DamianSeredyn/IHP__PLL0663/release/v.1.0.0/doc/Datasheet.md

# PLL0663 – Datasheet

Phase-locked loop in IHP SG13CMOS5L · Release v1.0.0

## 1. Overview

PLL0663 is a phase-locked loop for the IHP SG13CMOS5L process. It consists of a
phase-frequency detector (PFD), a charge pump (CP), several voltage-controlled oscillators (VCO)
selected by a VCO decoder, a programmable divider, an input register and a bandgap block with two on-chip voltage references. The loop
filter is **external** (off-chip).

### Key features

- Output frequency range: 32 kHz – 150 MHz
- Reference frequency: 32 kHz
- Divider ratio N: 2 – 9984; `f_out = N × f_ref / 2` (the output is divided by 2)
- Core supply `vp` 1.2 V; all circuits inside the PLL run from 1.2 V
- 3.3 V supply `vph` for the input buffers only; bandgap supply `vp_bandgap` 3.3 V or 1.8 V, depending on the reference under test (section 6.5)
- Serial input register (`clk_in`, `data_in`, `data_en`) for the divider code and the debug multiplexer code
- Debug output (`debug_out`) with a multiplexer for internal test signals
- Two on-chip bandgap voltage references (`bandgap_res`, `bandgap_selfbias`), outputs `vref_res` and `vref_sb`
- Power consumption up to 100 mW (at the highest output frequency)
- Lock time: 1 ms (see section 7 for conditions)
- Silicon area: 1050 µm × 1050 µm including sealring (1.1025 mm²)

## 2. Block diagram

<p align="center">
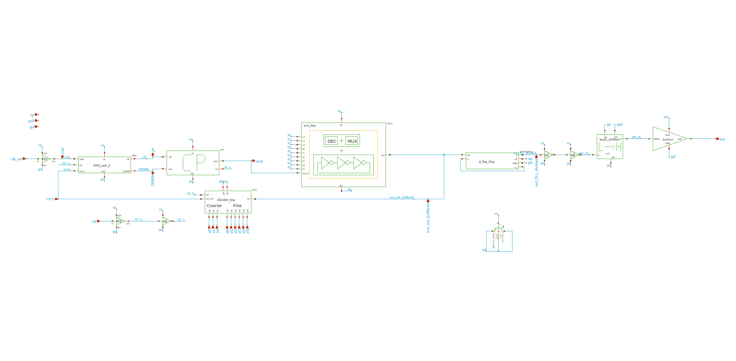
[picture p1: release/v.1.0.0/doc/img/PLL_top.png]
PLL top-level schematic (PLL_top)
  <br>
  <em>Figure 1: PLL top-level schematic (<code>PLL_top</code>)</em>
</p>

<p align="center">
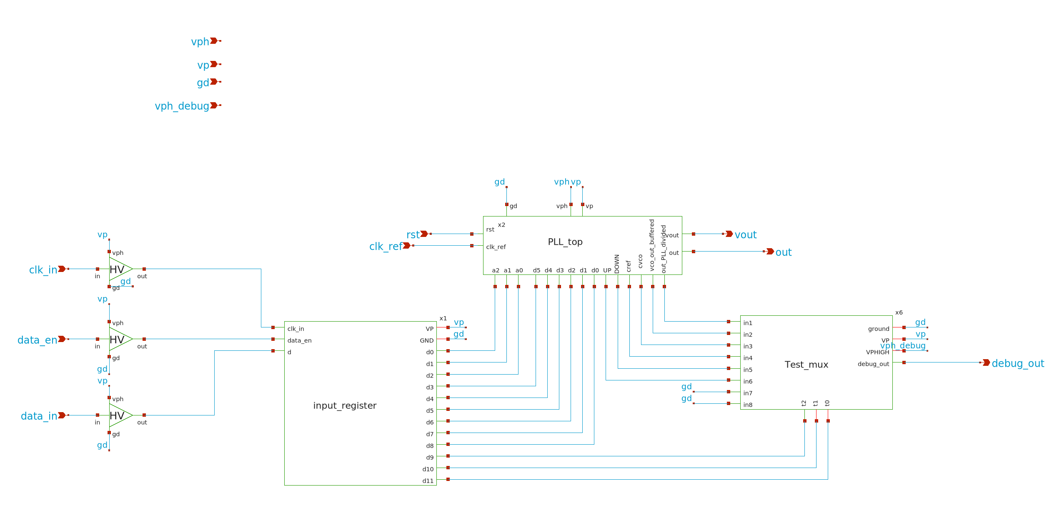
[picture p2: release/v.1.0.0/doc/img/Chip_top.png]
chip top-level schematic (Chip_top)
  <br>
  <em>Figure 2: chip top-level schematic (<code>Chip_top</code>)</em>
</p>

## 3. Pin description

Pin names are those of the extracted top-level subcircuit. All signal pins and the supply `vph`
are in the 3.3 V domain; the bandgap supply `vp_bandgap` is 3.3 V or 1.8 V (section 6.5); `vp` is the 1.2 V core supply. Only the input buffers are
supplied from `vph`; all circuits inside the PLL are supplied from `vp` (1.2 V).

| Pin | Direction | Domain | Description |
|---|---|---|---|
| `gd` | supply | 0 V | Ground |
| `vp` | supply | 1.2 V | Core supply (all circuits inside the PLL) |
| `vph` | supply | 3.3 V | 3.3 V supply of the input buffers only |
| `vp_bandgap` | supply | 3.3 V / 1.8 V | Bandgap supply: 3.3 V for `bandgap_res`, 1.8 V for `bandgap_selfbias` (section 6.5) |
| `clk_ref` | in | 3.3 V | Reference clock (32 kHz) |
| `rst` | in | 3.3 V | Reset, active high; resets all elements of the PLL |
| `clk_in` | in | 3.3 V | Input register: external clock of the serial interface |
| `data_in` | in | 3.3 V | Input register: serial data (divider code and debug multiplexer code) |
| `data_en` | in | 3.3 V | Input register: enable; while asserted, `data_in` is shifted into the register on successive `clk_in` clock cycles |
| `out` | out | 3.3 V | PLL output clock |
| `vout` | analog | 3.3 V | Charge-pump / VCO control node, connection of the external loop filter |
| `debug_out` | out | 3.3 V | Output of the debug multiplexer (internal test signals, selected via the input register) |
| `vref_sb` | analog | – | Reference voltage output of `bandgap_selfbias` (no internal buffer) |
| `vref_res` | analog | – | Reference voltage output of `bandgap_res` (no internal buffer) |

### 3.1 Input register

The input register is a serial-in, parallel-out (SIPO) shift register, loaded through `clk_in`,
`data_in` and `data_en`. `clk_in` is an external clock (independent of `clk_ref`). As long as
`data_en` is asserted, `data_in` is shifted into the register on successive `clk_in` clock cycles.

The serial word is 12 bits long:

| Bits | Field |
|---|---|
| D0 – D8 | divider code (9 bits) |
| D9 – D11 | code of the debug output multiplexer (3 bits, selects the signal routed to `debug_out`) |

The register content is valid only after the transmission of the last bit (D11) is complete.

<p align="center">
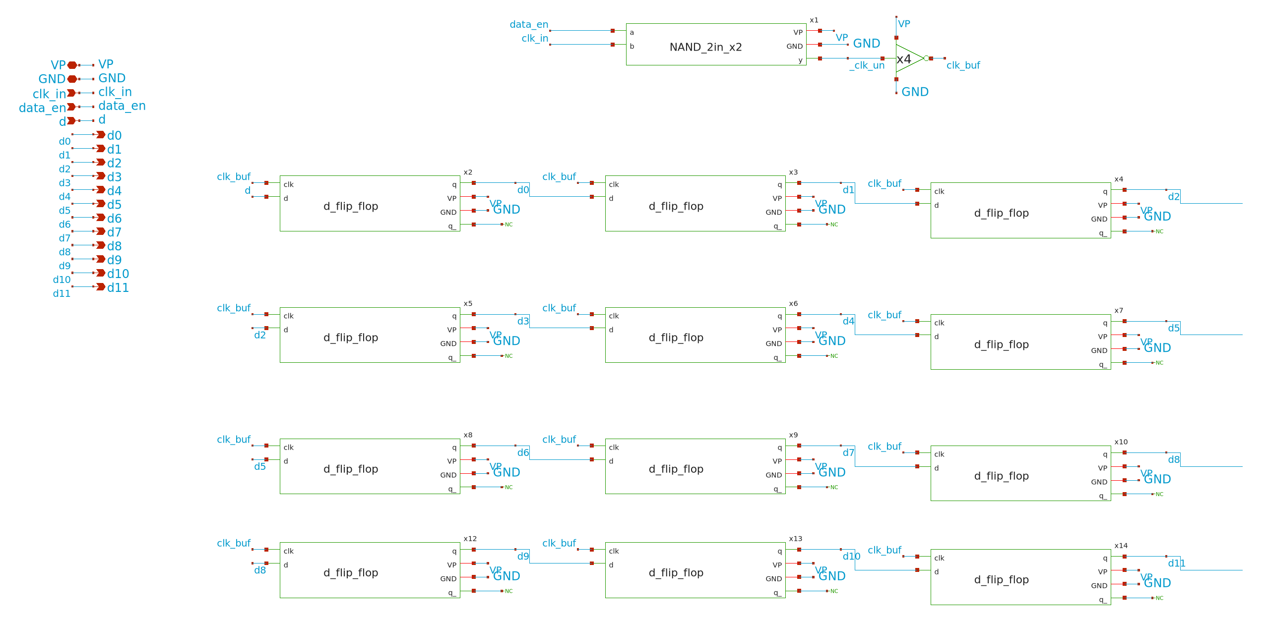
[picture p3: release/v.1.0.0/doc/img/input_register.png]
input register (input_register)
  <br>
  <em>Figure 3: input register (<code>input_register</code>)</em>
</p>

TODO: bit order on the line (assumed D0 first, D11 last), timing diagram (setup/hold of `data_in`
and `data_en` with respect to `clk_in`, maximum `clk_in` frequency), active level of `data_en`,
debug multiplexer codes and the signal selected by each code.

### 3.2 Output buffer and level shifters

<table>
<tr>
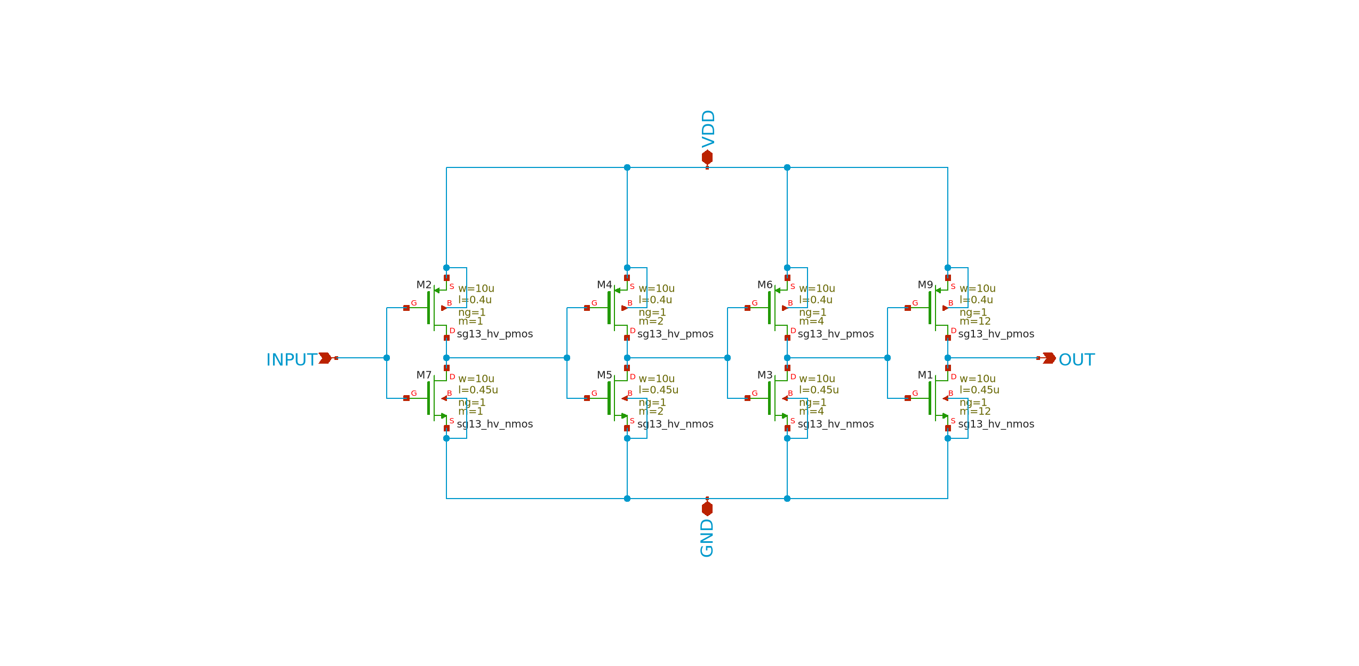
[picture p4: release/v.1.0.0/doc/img/buf.png]
output buffer (buf)
<td align="center" width="50%"><br><em>Figure 4: output buffer (<code>buf</code>)</em></td>
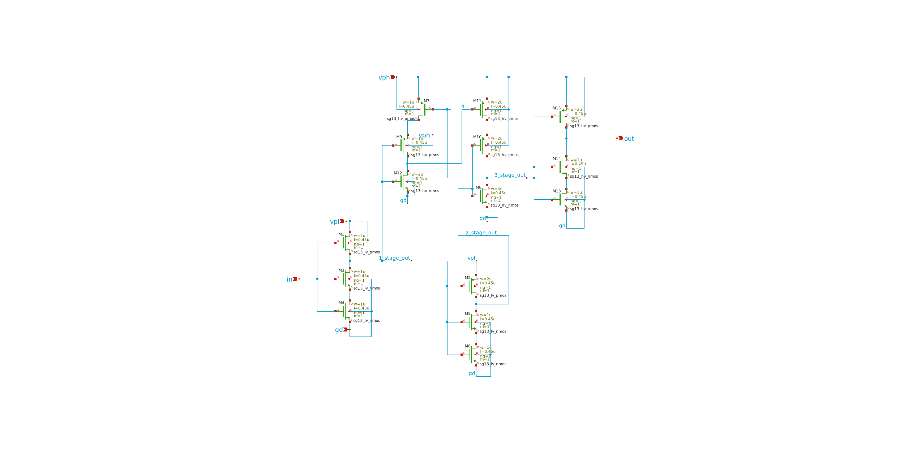
[picture p5: release/v.1.0.0/doc/img/level_shifter.png]
level shifter (level_shifter)
<td align="center" width="50%"><br><em>Figure 5: level shifter (<code>level_shifter</code>)</em></td>
</tr>
</table>

TODO: short description (which pins use them, 3.3 V to 1.2 V translation).

## 4. Operating conditions

| Parameter | Min | Typ | Max | Unit |
|---|---|---|---|---|
| Core supply `vp` | 1.08 | 1.2 | 1.32 | V |
| 3.3 V supply `vph` | 3.1 | 3.3 | 3.5 | V |
| Bandgap supply `vp_bandgap` (`bandgap_res`) | 2.97 | 3.3 | 3.63 | V |
| Bandgap supply `vp_bandgap` (`bandgap_selfbias`) | 1.62 | 1.8 | 1.98 | V |
| Temperature | -25 | 27 | 125 | °C |
| Reference frequency | – | 32 | – | kHz |

The ranges above are the simulated ranges. Process corners simulated: `mos_tt`, `mos_ss`, `mos_ff`,
`mos_sf`, `mos_fs`.

Absolute maximum ratings: TODO (take from the PDK documentation for the devices used).

## 5. Electrical characteristics

Conditions: process corner `mos_tt`, `vp` = 1.2 V, `vph` = 3.3 V, 27 °C unless stated otherwise.

| Parameter | Min | Typ | Max | Unit | Source |
|---|---|---|---|---|---|
| Output frequency | 0.032 | – | 150 | MHz | TODO: simulation reference |
| Divider ratio | 2 | – | 9984 | – | design |
| Lock time | – | 1 | – | ms | `PLL_top_tb.sch` |
| Power consumption | – | TODO | 100 | mW | TODO (at 150 MHz) |
| Charge-pump current | TODO | TODO | TODO | µA | TODO |
| VCO gain | TODO | TODO | TODO | MHz/V | TODO |
| Phase noise / jitter | TODO | TODO | TODO | – | TODO or "not characterised" |
| Output voltage `vref_res` (`bandgap_res`) | 1.203 | 1.209 | 1.209 | V | section 6.5 |
| Output voltage `vref_sb` (`bandgap_selfbias`) | 0.744 | 0.812 | 0.88 | V | section 6.5 |
| Temperature coefficient (`bandgap_res`) | – | 10.1 | 22.1 | ppm/°C | section 6.5 |
| Temperature coefficient (`bandgap_selfbias`) | – | 10.5 | 38.8 | ppm/°C | section 6.5 |
| Supply current (`bandgap_res`) | 0.368 | 0.407 | 0.436 | mA | section 6.5 |
| Supply current (`bandgap_selfbias`) | 8.186 | 38.033 | 85.617 | µA | section 6.5 |

Bandgap values: typical = `mos_tt`; min / max = extremes over the simulated corners (section 6.5).

### 5.1 Supply current

| Supply | Min | Nominal | Max | Unit | Conditions |
|---|---|---|---|---|---|
| `vp` (1.2 V core) | TODO | TODO | TODO | mA | TODO: output frequency / divider ratio, corner, temperature, supply |
| `vph` (3.3 V input buffers) | TODO | TODO | TODO | mA | TODO |

Nominal: `mos_tt`, `vp` = 1.2 V, `vph` = 3.3 V, 27 °C. Min / max: TODO (extremes over the corners,
temperature -25 – 125 °C and supply ranges of section 4).

The current of the bandgap supply `vp_bandgap` is given in section 6.5.

## 6. Functional description

### 6.1 Phase-frequency detector (PFD)

<p align="center">
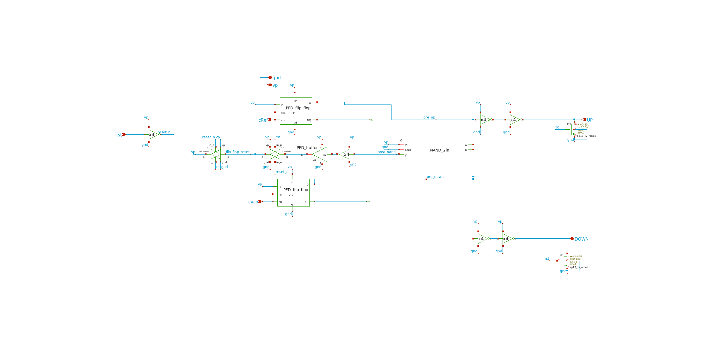
[picture p6: release/v.1.0.0/doc/img/PFD_cell_2.png]
PFD cell (PFD_cell_2)
  <br>
  <em>Figure 6: PFD cell (<code>PFD_cell_2</code>)</em>
</p>

<p align="center">
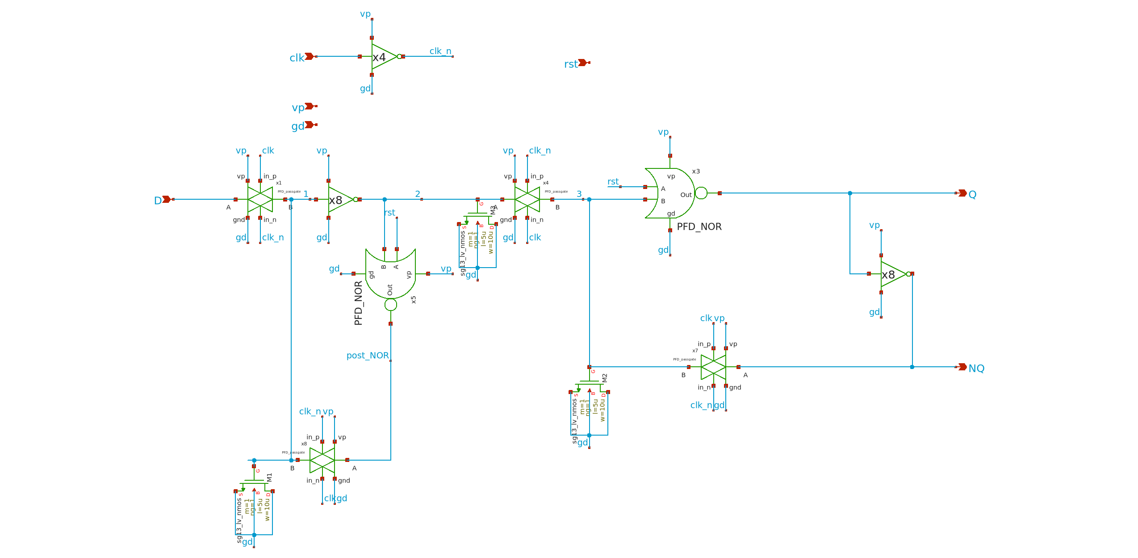
[picture p7: release/v.1.0.0/doc/img/PFD_flip_flop.png]
PFD flip-flop (PFD_flip_flop)
  <br>
  <em>Figure 7: PFD flip-flop (<code>PFD_flip_flop</code>)</em>
</p>

TODO: topology, dead zone / reset delay, input frequency range.

### 6.2 Charge pump (CP)

<p align="center">
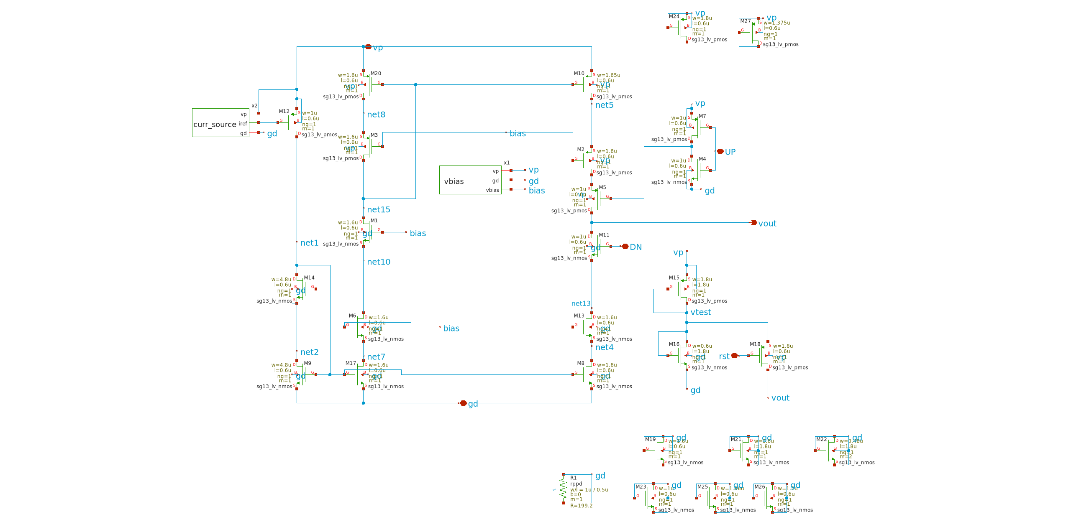
[picture p8: release/v.1.0.0/doc/img/charge_pump_cell.png]
charge pump cell (charge_pump_cell)
  <br>
  <em>Figure 8: charge pump cell (<code>charge_pump_cell</code>)</em>
</p>

<table>
<tr>
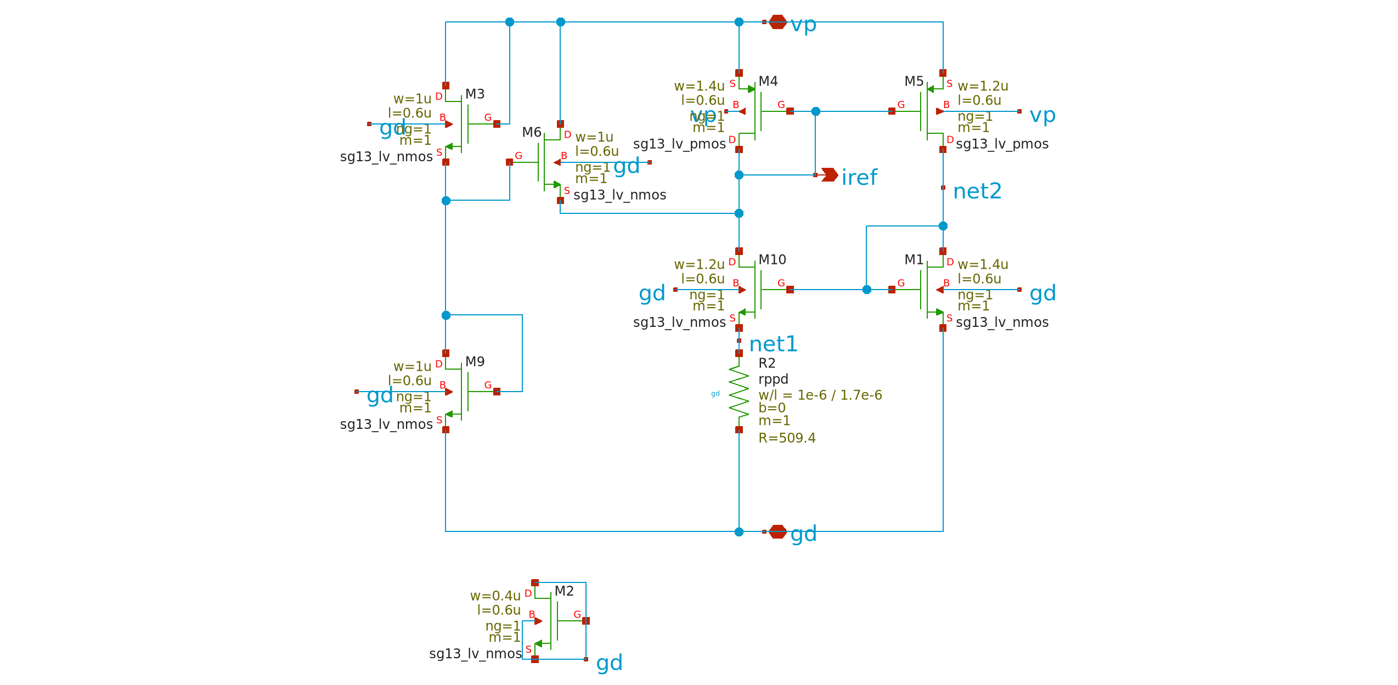
[picture p9: release/v.1.0.0/doc/img/curr_source.png]
current source (curr_source)
<td align="center" width="50%"><br><em>Figure 9: current source (<code>curr_source</code>)</em></td>
<td align="center" width="50%">bias generator (vbias)<br><em>Figure 10: bias generator (<code>vbias</code>)</em></td>
</tr>
</table>

TODO: topology, output current, up/down matching, output voltage range.

### 6.3 Voltage-controlled oscillators (VCO) and VCO decoder

<p align="center">
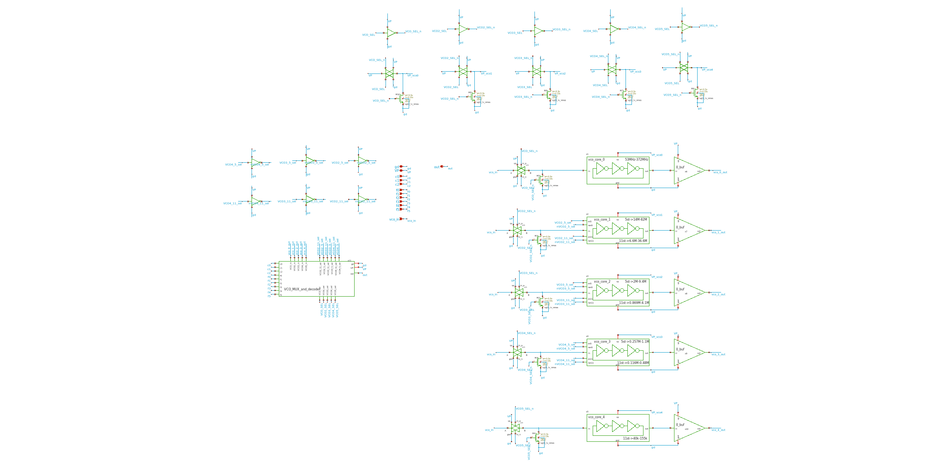
[picture p10: release/v.1.0.0/doc/img/vco_top.png]
VCO top level (vco_top)
  <br>
  <em>Figure 11: VCO top level (<code>vco_top</code>)</em>
</p>

<p align="center">
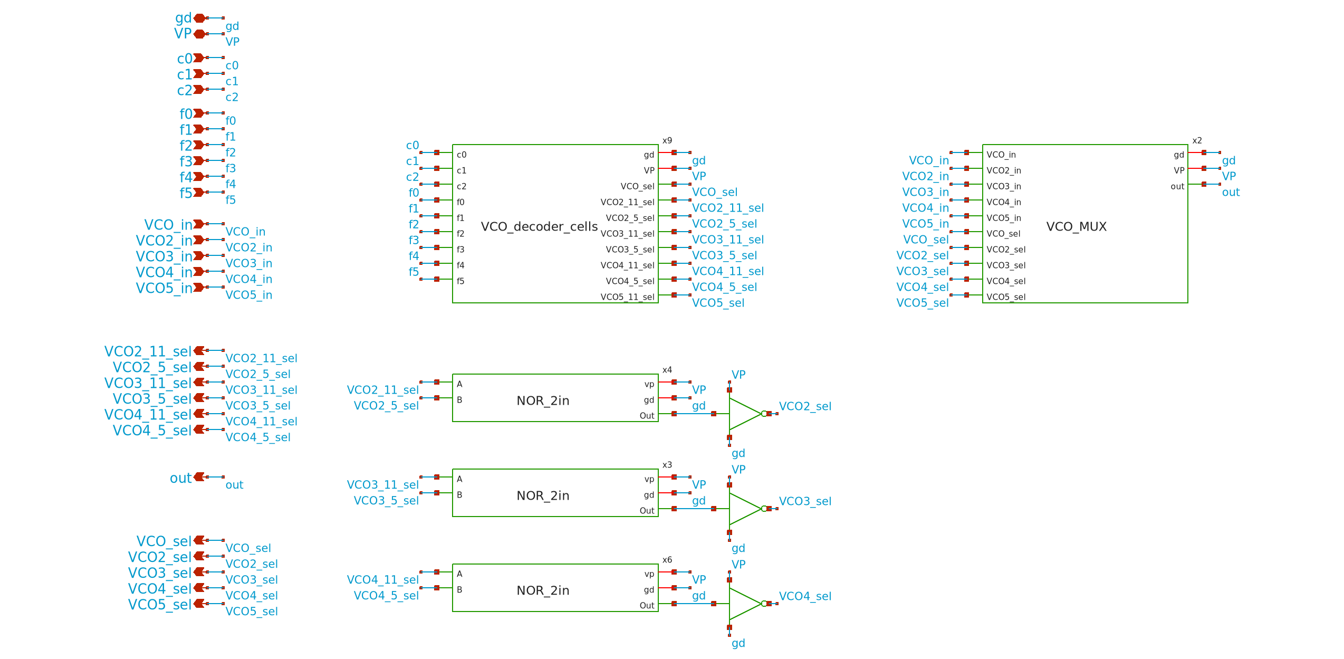
[picture p11: release/v.1.0.0/doc/img/VCO_MUX_and_decoder.png]
VCO multiplexer and decoder (VCO_MUX_and_decoder)
  <br>
  <em>Figure 12: VCO multiplexer and decoder (<code>VCO_MUX_and_decoder</code>)</em>
</p>

<p align="center">
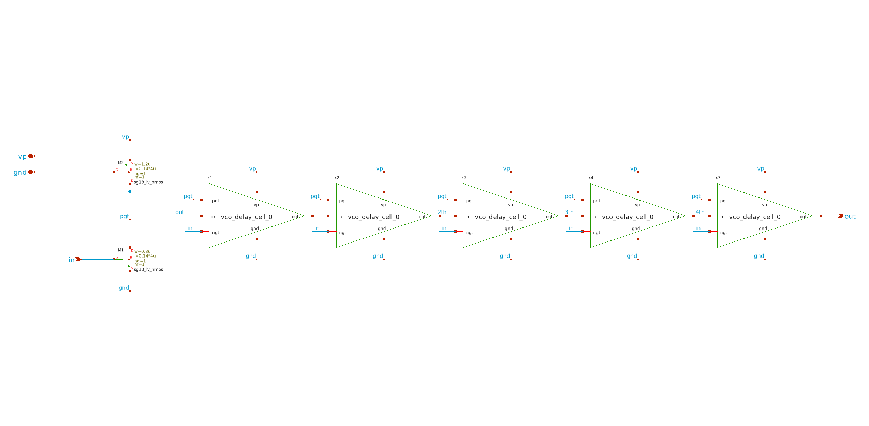
[picture p12: release/v.1.0.0/doc/img/vco_core_0.png]
VCO core 0 (vco_core_0)
  <br>
  <em>Figure 13: VCO core 0 (<code>vco_core_0</code>)</em>
</p>

<p align="center">
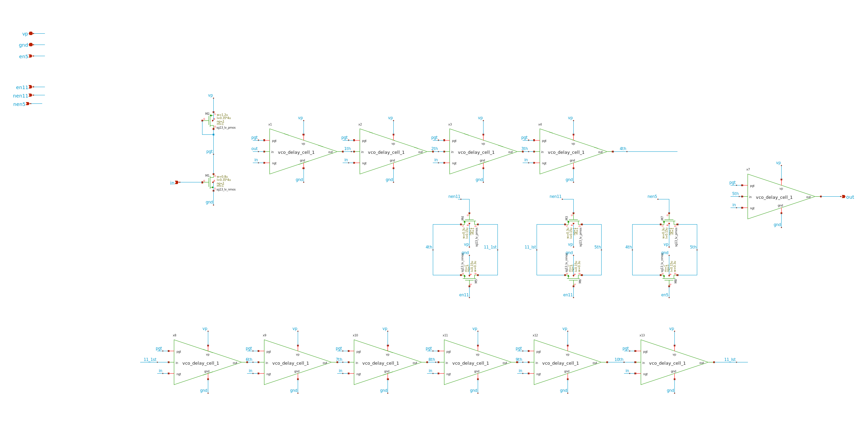
[picture p13: release/v.1.0.0/doc/img/vco_core_1.png]
VCO core 1 (vco_core_1)
  <br>
  <em>Figure 14: VCO core 1 (<code>vco_core_1</code>)</em>
</p>

<p align="center">
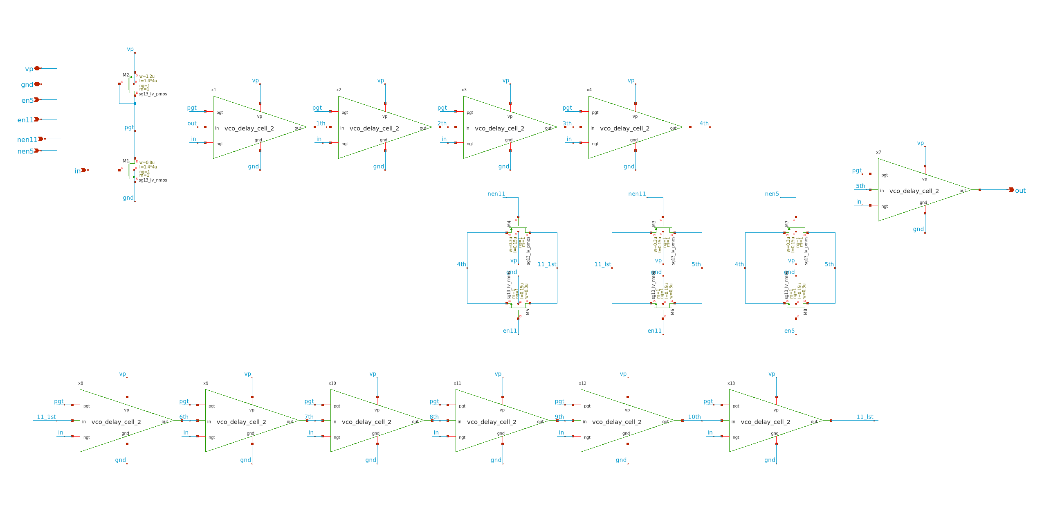
[picture p14: release/v.1.0.0/doc/img/vco_core_2.png]
VCO core 2 (vco_core_2)
  <br>
  <em>Figure 15: VCO core 2 (<code>vco_core_2</code>)</em>
</p>

<p align="center">
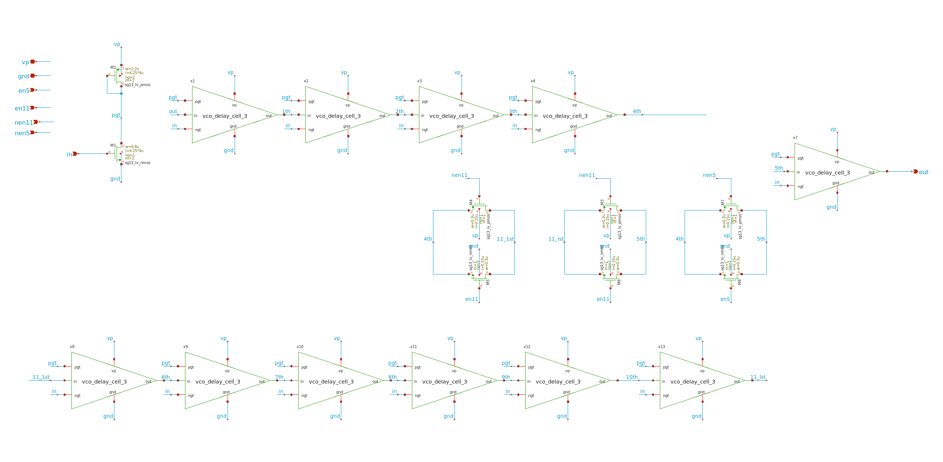
[picture p15: release/v.1.0.0/doc/img/vco_core_3.png]
VCO core 3 (vco_core_3)
  <br>
  <em>Figure 16: VCO core 3 (<code>vco_core_3</code>)</em>
</p>

<p align="center">
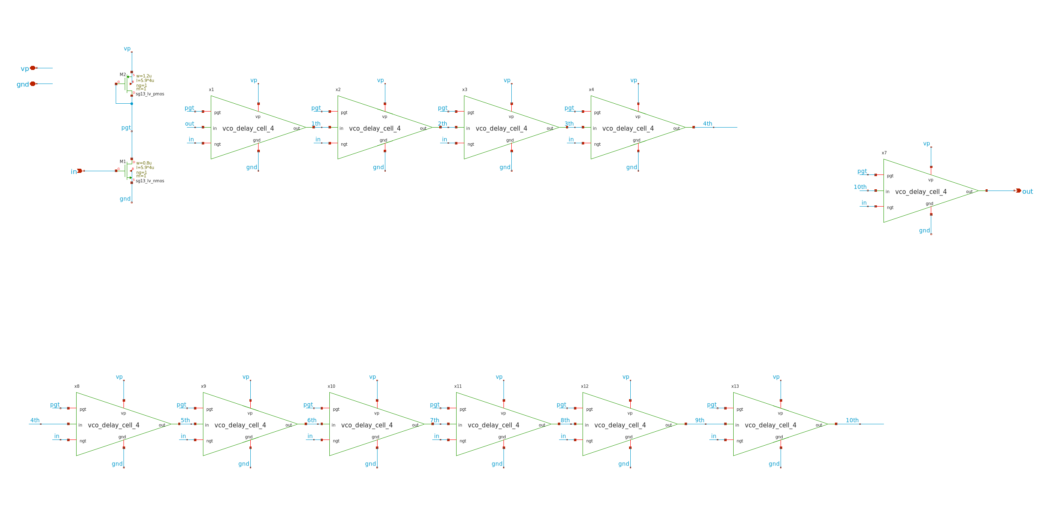
[picture p16: release/v.1.0.0/doc/img/vco_core_4.png]
VCO core 4 (vco_core_4)
  <br>
  <em>Figure 17: VCO core 4 (<code>vco_core_4</code>)</em>
</p>

The PLL contains five VCO cores (`vco_core_0` – `vco_core_4`), each covering a part of the output
frequency range. The VCO decoder selects which VCO is active.

TODO: oscillator topology, frequency range of each VCO, what drives the decoder
(divider code or a separate input) and the decoder codes (table).

### 6.4 Divider

<p align="center">
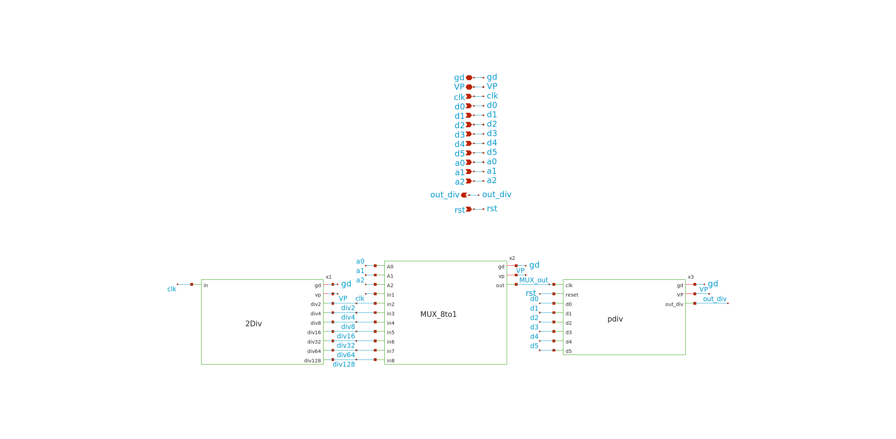
[picture p17: release/v.1.0.0/doc/img/Divider_top.png]
divider top level (Divider_top)
  <br>
  <em>Figure 18: divider top level (<code>Divider_top</code>)</em>
</p>

The output of the VCO is divided by 2 to form `out`, therefore `f_out = N × f_ref / 2`. With
`f_ref` = 32 kHz the minimum ratio N = 2 gives the lowest output frequency of 32 kHz.

The divider code is 9 bits wide (D0 – D8) and is written through the input register
(section 3.1).

TODO: structure, encoding of the 9-bit code into the ratio 2 – 9984, timing of changes.

### 6.5 Bandgap reference

The bandgap block (`bandgap_top`) contains two independent voltage references, `bandgap_res` and
`bandgap_selfbias`. Both are supplied from the same supply pins (`vp_bandgap`, `gd`), so the supply
voltage must be chosen according to the reference under test:

| Reference | Output pin | Designed for `vp_bandgap` |
|---|---|---|
| `bandgap_res` | `vref_res` | 3.3 V |
| `bandgap_selfbias` | `vref_sb` | 1.8 V |

Applying 3.3 V to `bandgap_selfbias` does not damage it, but changes the reference voltage it
generates.

The reference voltage must be measured at the output pin of the selected reference (`vref_res` for
`bandgap_res`, `vref_sb` for `bandgap_selfbias`). The outputs have no internal buffer stages, so large
loads must be avoided during tests; external voltage buffers are recommended.

Simulation results over process corners:

**`bandgap_res`** (pin `vref_res`)

| Corner | `vp_bandgap` [V] | V_ref [V] | I_supply [mA] | P_supply [mW] | TC [ppm/°C] |
|---|---|---|---|---|---|
| `mos_tt` | 3.3 | 1.209 | 0.407 | 1.343 | 10.136 |
| `mos_ss` | 2.97 | 1.207 | 0.368 | 1.095 | 22.053 |
| `mos_ff` | 3.63 | 1.203 | 0.436 | 1.585 | 20.763 |

**`bandgap_selfbias`** (pin `vref_sb`)

| Corner | `vp_bandgap` [V] | V_ref [V] | I_supply [µA] | P_supply [µW] | TC [ppm/°C] |
|---|---|---|---|---|---|
| `mos_tt` | 1.8 | 0.812 | 38.033 | 68.46 | 10.487 |
| `mos_ss` | 1.62 | 0.744 | 8.186 | 13.261 | 13.096 |
| `mos_ff` | 1.98 | 0.880 | 85.617 | 169.522 | 38.808 |

#### Test connection of the bandgap

- `vp_bandgap`: TODO (3.3 V for `bandgap_res`, 1.8 V for `bandgap_selfbias`; decoupling, how to switch the supply)
- Output `vref_res` / `vref_sb`: TODO (measurement with a high-impedance instrument or an external voltage buffer; maximum allowed load)
- TODO: other connections required during the bandgap test

<!-- Uncomment after adding the file to doc/img/:
<p align="center">
  <img src="img/bandgap_test_setup.png" alt="bandgap test connection" width="90%"><br>
  <em>Figure N: proposed connection of the bandgap for testing</em>
</p>
-->

TODO: topology of both references, schematic figures, temperature range used for the TC, start-up
behaviour, whether the references are used inside the chip.

### 6.6 External loop filter
The loop filter is not part of the chip and is connected to `vout`. The simulated results in
section 7 were obtained with:

| Element | Value |
|---|---|
| R1 | 50 kΩ |
| C1 | 100 pF |
| C2 (if used) | 1 µF |

<p align="center">
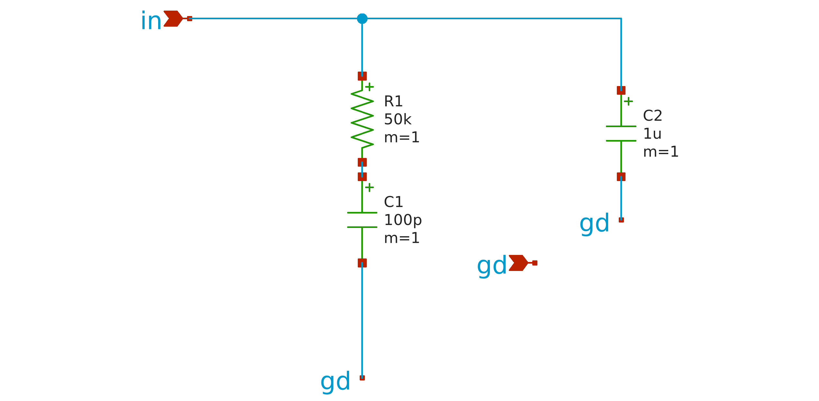
[picture p18: release/v.1.0.0/doc/img/RC_filter.png]
external loop filter (RC_filter)
  <br>
  <em>Figure 19: external loop filter (<code>RC_filter</code>)</em>
</p>

Topology: the filter node `in` is connected to `vout`. C2 connects `vout` to ground, and in parallel to it R1 in series with C1 connects `vout` to ground.

### 6.7 Debug output multiplexer

The debug output multiplexer routes one of the internal test signals to `debug_out`. The selected
signal is set by the 3-bit debug code (D9 – D11) written through the input register (section 3.1).
The multiplexer output is buffered by a low-power buffer (`buf_lp`). These blocks are intended for
testing and debugging only.

<p align="center">
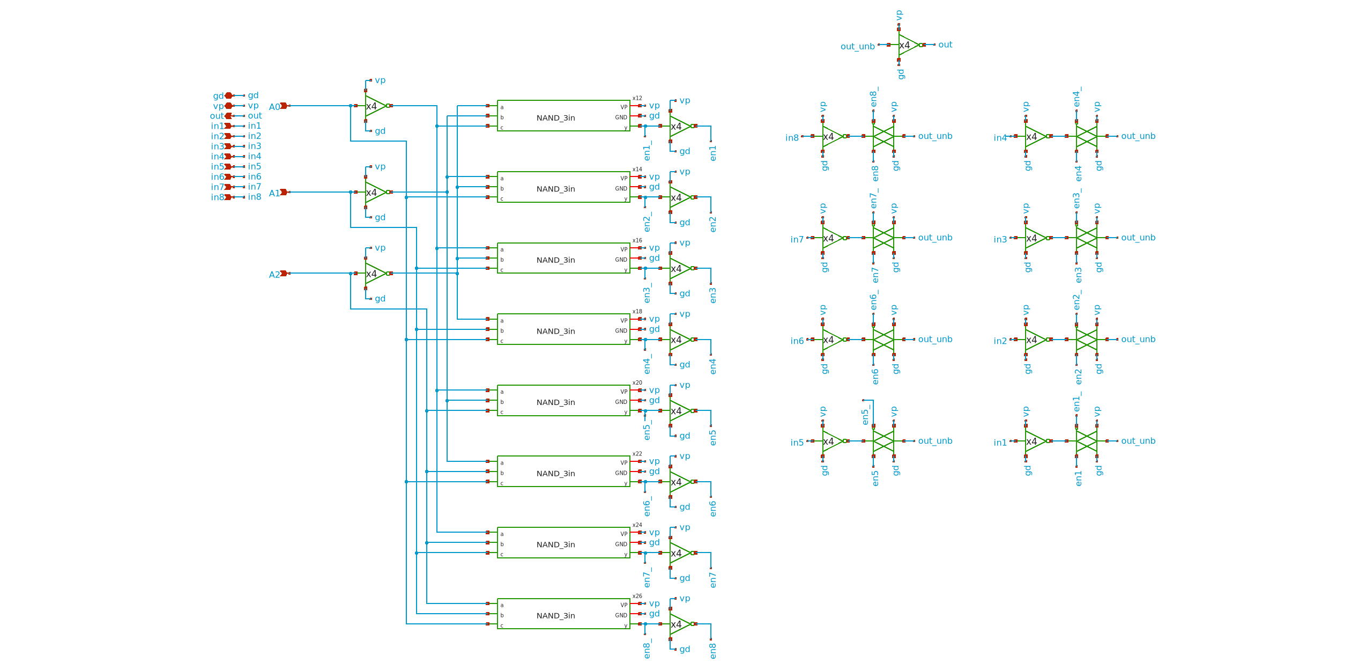
[picture p19: release/v.1.0.0/doc/img/mux8to1.png]
8-to-1 multiplexer (mux8to1)
  <br>
  <em>Figure 20: 8-to-1 multiplexer (<code>mux8to1</code>)</em>
</p>

<p align="center">
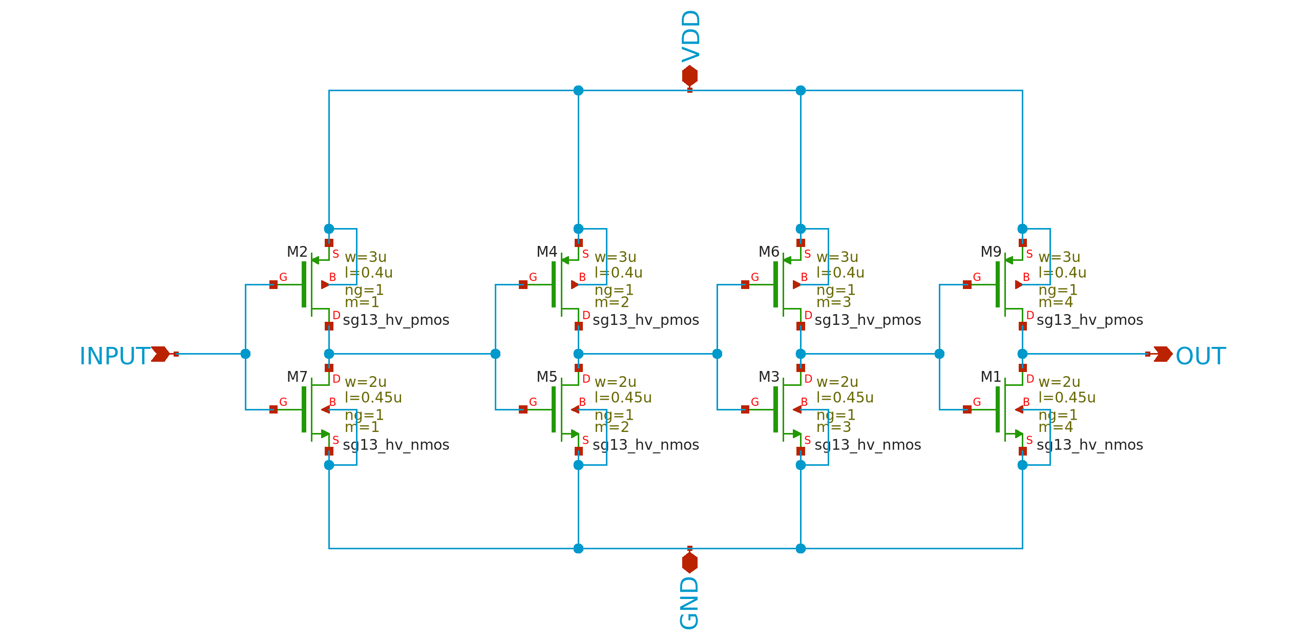
[picture p20: release/v.1.0.0/doc/img/buf_lp.png]
debug output buffer (buf_lp)
  <br>
  <em>Figure 21: debug output buffer (<code>buf_lp</code>)</em>
</p>

Signals connected to the inputs of `mux8to1`:

| Mux input | Signal | Description |
|---|---|---|
| in1 | `out_PLL_divided` | PLL output signal after the divider |
| in2 | `vco_out_buffered` | buffered VCO output |
| in3 | `cvco` | VCO clock |
| in4 | `cref` | reference clock |
| in5 | `DOWN` | PFD DOWN signal |
| in6 | `UP` | PFD UP signal |
| in7 | `gd` | tied to ground (unused) |
| in8 | `gd` | tied to ground (unused) |

TODO: select code (D9 – D11) of each input.

## 7. Simulation results

| Testbench | Conditions | Result |
|---|---|---|
| `testbenches/tran/xschem/top/PLL_top_tb.sch` | `mos_tt`, 1.2 V, 27 °C | lock at 1 MHz, lock time 1 ms |

Simulated ranges: temperature -25 / 27 / 125 °C; `vp` 1.08 / 1.2 / 1.32 V; `vph` 3.1 / 3.3 / 3.5 V;
corners `mos_tt`, `mos_ss`, `mos_ff`, `mos_sf`, `mos_fs`.

Plots: `top_results/` (TODO: list file names).

Block-level results (VCO tuning curve, charge-pump current vs. output voltage, PFD transfer
function) and results over process corners, supply and temperature are collected in the
`measurements` directory (TODO: exact path).

Post-layout (PEX) simulation: all blocks were simulated individually from extracted layout, and
the complete PLL was simulated from extracted layout as well. Only parasitic capacitances (C) were
extracted; parasitic resistances were not included. The extraction was done with Magic, run
through the `sak-pex.sh` script.
TODO: Magic version and extraction options.

## 8. Startup and usage

1. Apply supplies in this order: TODO (core 1.2 V / pad 3.3 V).
2. Connect the external loop filter to `vout` (section 6.6).
3. Apply the 32 kHz reference clock to `clk_ref`.
4. Write the divider code and the debug multiplexer code serially into the input register using
   `clk_in`, `data_in` and `data_en` (section 3.1, 6.4).
5. Wait for lock (about 1 ms in simulation).

### 8.1 Proposed connection for physical tests

| Pin | Proposed connection |
|---|---|
| `gd` | Ground |
| `vp` | 1.2 V supply (TODO: decoupling) |
| `vph` | 3.3 V supply (TODO: decoupling) |
| `vp_bandgap` | 3.3 V (`bandgap_res`) or 1.8 V (`bandgap_selfbias`) |
| `clk_ref` | 32 kHz reference clock source |
| `rst` | TODO: source (active high) |
| `clk_in`, `data_in`, `data_en` | TODO: source of the serial interface (e.g. microcontroller / FPGA), 3.3 V levels |
| `vout` | External loop filter (section 6.6): R1 = 50 kΩ, C1 = 100 pF, C2 = 1 µF |
| `out` | TODO: load / instrument |
| `debug_out` | TODO: load / instrument |
| `vref_res`, `vref_sb` | High-impedance instrument or external voltage buffer (section 6.5) |

TODO: schematic of the proposed test connection. Add the image to `doc/img/` and uncomment the
figure below.

<!-- Uncomment after adding the file to doc/img/:
<p align="center">
  <img src="img/test_setup.png" alt="proposed test connection" width="90%"><br>
  <em>Figure N: proposed connection of PLL0663 for physical tests</em>
</p>
-->

## 9. Physical implementation

| Item | Value |
|---|---|
| Technology | IHP SG13CMOS5L |
| Top cell | `PLL0663` |
| Layout | `release/v.1.0.0/gds/PLL0663.gds` |
| Size | 1050 µm × 1050 µm (sealring) |
| Pads | cells from the PDK I/O library `sg13cmos5l_io`, not modified |
| PDK revision | `a49358cc0b20635fcb53c0940505e3563763fc7a` (IHP-Open-PDK) |

## 10. Verification

| Check | Result |
|---|---|
| DRC main table, mandatory rules | PASS |
| DRC main table, recommended rules | 41 findings (`Pad.fR_TM1`, unmodified library pads), waived |
| DRC density table | PASS |
| LVS | PASS |

Details and reports: `release/v.1.0.0/ReleaseNote.md` and `PLL0663-main/verification/`.

## 11. Known limitations

- The loop filter must be designed by the user.
- TODO: further limitations (e.g. no silicon measurements yet, characterisation over temperature).

## 12. Revision history

| Version | Date | Changes |
|---|---|---|
| 1.0.0 | TODO | Initial release |
