DamianSeredyn/IHP__PLL0663/doc/img/Bonding/PLL0663_bondplan_white.png

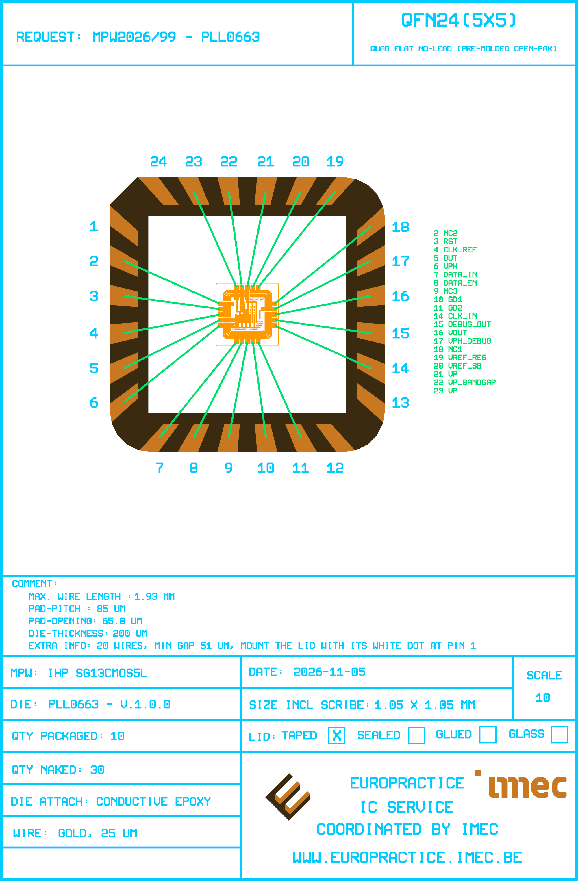
doc/img/Bonding/PLL0663_bondplan_white.png
