DamianSeredyn/IHP__PLL0663/doc/img/input_register.png

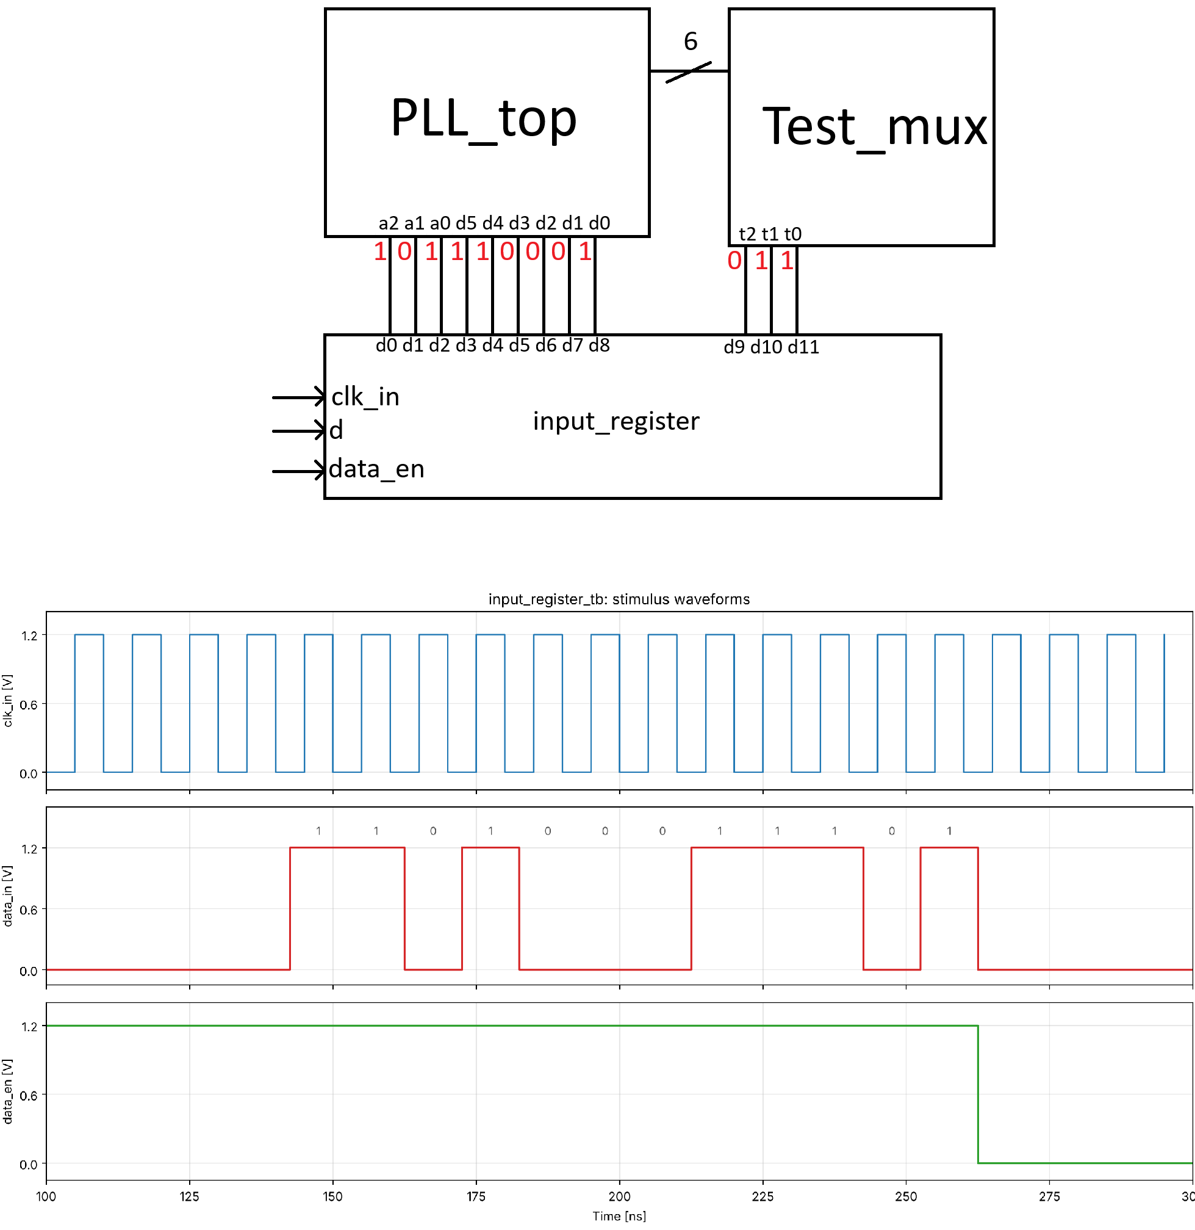
doc/img/input_register.png
