DamianSeredyn/IHP__PLL0663/release/v.1.0.0/doc/top_results/PLL_top_extracted_1MHz.png

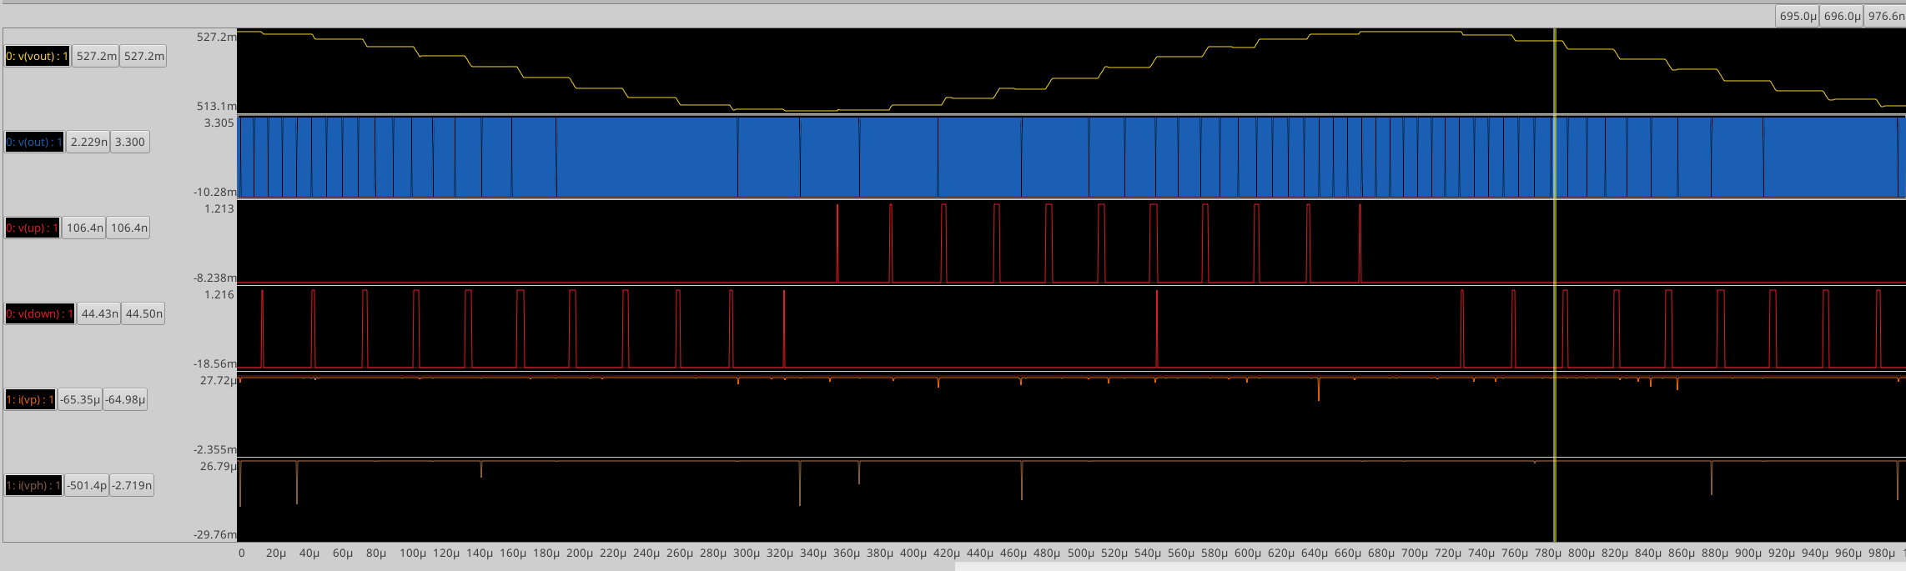
release/v.1.0.0/doc/top_results/PLL_top_extracted_1MHz.png
