DamianSeredyn/IHP__PLL0663/PLL0663-main/netlist/schematic/chip_top.spice

** sch_path: /foss/designs/IHP__PLL0663/PLL0663-main/schematic/xschem/top/chip_top.sch
.subckt chip_top vp gd clk_in data_en data_in clk_ref rst out vout vph debug_out
*.PININFO vp:I gd:I clk_in:I data_en:I data_in:I clk_ref:I rst:I out:O vout:O vph:I debug_out:O
x2 vp vph gd clk_ref out net4 net6 net2 net7 net8 net9 net5 net1 net3 rst vout net19 net21 net20 net18 net17 net16 PLL_top
x1 vp gd net12 net11 net10 net1 net2 net3 net4 net5 net6 net7 net8 net9 net13 net14 net15 input_register
x3 vp data_in net10 gd buffer_hv
x4 vp data_en net11 gd buffer_hv
x5 vp clk_in net12 gd buffer_hv
x6 net15 net14 net13 gd vp debug_out net16 net17 net18 net19 net20 net21 gd gd vph Test_mux
.ends

* expanding   symbol:  /foss/designs/IHP__PLL0663/PLL0663-main/schematic/xschem/top/PLL_top.sym # of pins=22
** sym_path: /foss/designs/IHP__PLL0663/PLL0663-main/schematic/xschem/top/PLL_top.sym
** sch_path: /foss/designs/IHP__PLL0663/PLL0663-main/schematic/xschem/top/PLL_top.sch
.subckt PLL_top vp vph gd clk_ref out d5 d3 a1 d2 d1 d0 d4 a2 a0 rst vout cref UP DOWN cvco vco_out_buffered out_PLL_divided
*.PININFO clk_ref:I out:O gd:I vph:I vp:I a0:I a1:I a2:I d0:I d1:I d2:I d3:I d4:I d5:I rst:I vout:O UP:O DOWN:O cvco:O
*+ vco_out_buffered:O out_PLL_divided:O cref:O
x2 vp clk_ref cref gd buffer_hv
xPFD gd vp cref UP DOWN cvco rst_lv PFD_cell_2
xBUF vph aft_LS out gd buf
xDiv gd vp vco_out_buffered d0 d1 d2 d3 d4 d5 a0 a1 a2 cvco rst_lv Divider_top
xOutFlipFlop out_PLL_divided vp gd net1 vco_out_buffered net1 d_flip_flop
xLS vph aft_LS vp pre_LS gd level_shifter
x1 out_PLL_divided net2 vp gd inverter_x2
x3 net2 pre_LS vp gd inverter_x4_top
xCP vp UP vout DOWN rst_n gd charge_pump_cell
x9 rst_lv rst_n vp gd inverter_x4
xVCO vco_out_buffered gd vp a0 a1 a2 d0 d1 d2 d3 d4 d5 vout vco_top
x4 vp rst rst_lv gd buffer_hv
MM1 gd vp gd gd sg13_lv_nmos w=240u l=5u ng=1
.ends


* expanding   symbol:  /foss/designs/IHP__PLL0663/PLL0663-main/schematic/xschem/divider/input_register.sym # of pins=17
** sym_path: /foss/designs/IHP__PLL0663/PLL0663-main/schematic/xschem/divider/input_register.sym
** sch_path: /foss/designs/IHP__PLL0663/PLL0663-main/schematic/xschem/divider/input_register.sch
.subckt input_register VP GND clk_in data_en d d0 d1 d2 d3 d4 d5 d6 d7 d8 d9 d10 d11
*.PININFO VP:B clk_in:I GND:B data_en:I d:I d0:O d2:O d3:O d4:O d5:O d6:O d7:O d1:O d8:O d9:O d10:O d11:O
x2 d0 VP GND net1 clk_buf d d_flip_flop
x3 d1 VP GND net2 clk_buf d0 d_flip_flop
x4 d2 VP GND net3 clk_buf d1 d_flip_flop
x5 d3 VP GND net4 clk_buf d2 d_flip_flop
x6 d4 VP GND net5 clk_buf d3 d_flip_flop
x7 d5 VP GND net6 clk_buf d4 d_flip_flop
x8 d6 VP GND net7 clk_buf d5 d_flip_flop
x9 d7 VP GND net8 clk_buf d6 d_flip_flop
x10 d8 VP GND net9 clk_buf d7 d_flip_flop
x11 _clk_un clk_buf VP GND inverter_x4
x12 d9 VP GND net10 clk_buf d8 d_flip_flop
x13 d10 VP GND net11 clk_buf d9 d_flip_flop
x14 d11 VP GND net12 clk_buf d10 d_flip_flop
* noconn #net1
* noconn #net2
* noconn #net3
* noconn #net4
* noconn #net5
* noconn #net6
* noconn #net7
* noconn #net8
* noconn #net9
* noconn #net10
* noconn #net11
* noconn #net12
x1 VP GND data_en _clk_un clk_in NAND_2in_x2
.ends


* expanding   symbol:  /foss/designs/IHP__PLL0663/PLL0663-main/schematic/xschem/misc/buffer_hv.sym # of pins=4
** sym_path: /foss/designs/IHP__PLL0663/PLL0663-main/schematic/xschem/misc/buffer_hv.sym
** sch_path: /foss/designs/IHP__PLL0663/PLL0663-main/schematic/xschem/misc/buffer_hv.sch
.subckt buffer_hv vph in out gd
*.PININFO in:I out:O vph:I gd:I
MM1 buf_stage_1 in vph vph sg13_hv_pmos w=4u l=0.45u ng=1
MM2 buf_stage_1 in gd gd sg13_hv_nmos w=4u l=0.45u ng=1
MM3 net1 buf_stage_1 vph vph sg13_hv_pmos w=4u l=0.45u ng=1
MM4 net1 buf_stage_1 gd gd sg13_hv_nmos w=4u l=0.45u ng=1
MM5 buf_stage_2 net1 vph vph sg13_hv_pmos w=3u l=0.45u ng=1
MM6 buf_stage_2 net1 gd gd sg13_hv_nmos w=3u l=0.45u ng=1
MM7 net2 buf_stage_2 vph vph sg13_hv_pmos w=3u l=0.45u ng=1
MM8 net2 buf_stage_2 gd gd sg13_hv_nmos w=3u l=0.45u ng=1
MM9 buf_stage_3 net2 vph vph sg13_hv_pmos w=2u l=0.45u ng=1
MM10 buf_stage_3 net2 gd gd sg13_hv_nmos w=2u l=0.45u ng=1
MM11 net3 buf_stage_3 vph vph sg13_hv_pmos w=2u l=0.45u ng=1
MM12 net3 buf_stage_3 gd gd sg13_hv_nmos w=2u l=0.45u ng=1
MM13 buf_stage_4 net3 vph vph sg13_hv_pmos w=1u l=0.45u ng=1
MM14 buf_stage_4 net3 gd gd sg13_hv_nmos w=1u l=0.45u ng=1
MM15 out buf_stage_4 vph vph sg13_hv_pmos w=1u l=0.45u ng=1
MM16 out buf_stage_4 gd gd sg13_hv_nmos w=1u l=0.45u ng=1
.ends


* expanding   symbol:  /foss/designs/IHP__PLL0663/PLL0663-main/schematic/xschem/misc/Test_mux.sym # of pins=15
** sym_path: /foss/designs/IHP__PLL0663/PLL0663-main/schematic/xschem/misc/Test_mux.sym
** sch_path: /foss/designs/IHP__PLL0663/PLL0663-main/schematic/xschem/misc/Test_mux.sch
.subckt Test_mux t0 t1 t2 ground VP debug_out in1 in2 in3 in4 in5 in6 in7 in8 VPHIGH
*.PININFO ground:B VP:B debug_out:O in1:I in2:I in3:I in4:I in5:I in6:I in7:I in8:I VPHIGH:B t2:I t1:I t0:I
x2 VP net1 debug_out ground buf_lp
x1 ground VP t0 MUX_out in1 in2 in3 in4 in5 in6 in7 t1 in8 t2 mux8to1
x3 VPHIGH net1 VP MUX_out ground debug_level_shifter
.ends


* expanding   symbol:  /foss/designs/IHP__PLL0663/PLL0663-main/schematic/xschem/PFD/PFD_cell_2.sym # of pins=7
** sym_path: /foss/designs/IHP__PLL0663/PLL0663-main/schematic/xschem/PFD/PFD_cell_2.sym
** sch_path: /foss/designs/IHP__PLL0663/PLL0663-main/schematic/xschem/PFD/PFD_cell_2.sch
.subckt PFD_cell_2 gnd vp cRef UP DOWN cVco rst
*.PININFO gnd:B vp:B cRef:I cVco:I rst:I UP:O DOWN:O
MM4 UP rst gnd gnd sg13_lv_nmos w=0.45u l=0.15u ng=1
MM5 DOWN rst gnd gnd sg13_lv_nmos w=0.45u l=0.15u ng=1
x1 rst vp flip_flop_reset vp gnd reset_n PFD_passgate
x3 reset_n vp flip_flop_reset net3 gnd rst PFD_passgate
x7 vp gnd pre_up post_nand pre_down NAND_2in
* noconn #net5
x8 gnd vp net3 net4 PFD_buffor
x11 cRef flip_flop_reset vp pre_up net5 vp gnd PFD_flip_flop
x12 cVco flip_flop_reset vp pre_down net6 vp gnd PFD_flip_flop
* noconn #net6
x2 pre_down net1 vp gnd PFD_inverter_x4
x4 net1 DOWN vp gnd PFD_inverter_x4
x5 net2 UP vp gnd PFD_inverter_x4
x6 pre_up net2 vp gnd PFD_inverter_x4
x9 rst reset_n vp gnd PFD_inverter_x4
x10 post_nand net4 vp gnd PFD_inverter_x4
.ends


* expanding   symbol:  /foss/designs/IHP__PLL0663/PLL0663-main/schematic/xschem/buf/buf.sym # of pins=4
** sym_path: /foss/designs/IHP__PLL0663/PLL0663-main/schematic/xschem/buf/buf.sym
** sch_path: /foss/designs/IHP__PLL0663/PLL0663-main/schematic/xschem/buf/buf.sch
.subckt buf VDD INPUT OUT GND
*.PININFO INPUT:I VDD:B GND:B OUT:O
MM9 OUT net3 VDD VDD sg13_hv_pmos w=10u l=0.4u ng=1 m=12
MM6 net3 net2 VDD VDD sg13_hv_pmos w=10u l=0.4u ng=1 m=4
MM4 net2 net1 VDD VDD sg13_hv_pmos w=10u l=0.4u ng=1 m=2
MM2 net1 INPUT VDD VDD sg13_hv_pmos w=10u l=0.4u ng=1
MM1 OUT net3 GND GND sg13_hv_nmos w=10u l=0.45u ng=1 m=12
MM3 net3 net2 GND GND sg13_hv_nmos w=10u l=0.45u ng=1 m=4
MM5 net2 net1 GND GND sg13_hv_nmos w=10u l=0.45u ng=1 m=2
MM7 net1 INPUT GND GND sg13_hv_nmos w=10u l=0.45u ng=1
.ends


* expanding   symbol:  /foss/designs/IHP__PLL0663/PLL0663-main/schematic/xschem/divider/Divider_top.sym # of pins=14
** sym_path: /foss/designs/IHP__PLL0663/PLL0663-main/schematic/xschem/divider/Divider_top.sym
** sch_path: /foss/designs/IHP__PLL0663/PLL0663-main/schematic/xschem/divider/Divider_top.sch
.subckt Divider_top gd VP clk d0 d1 d2 d3 d4 d5 a0 a1 a2 out_div rst
*.PININFO gd:B clk:I VP:B out_div:O d0:I d1:I d2:I d3:I d4:I d5:I a0:I a1:I a2:I rst:I
x1 gd VP clk div2 div4 div8 div16 div32 div64 div128 2Div
x2 gd VP a0 MUX_out clk div2 div4 div8 div16 div32 div64 a1 div128 a2 MUX_8to1
x3 gd VP MUX_out rst d0 d1 d2 d3 d4 d5 out_div pdiv
.ends


* expanding   symbol:  /foss/designs/IHP__PLL0663/PLL0663-main/schematic/xschem/divider/d_flip_flop.sym # of pins=6
** sym_path: /foss/designs/IHP__PLL0663/PLL0663-main/schematic/xschem/divider/d_flip_flop.sym
** sch_path: /foss/designs/IHP__PLL0663/PLL0663-main/schematic/xschem/divider/d_flip_flop.sch
.subckt d_flip_flop q VP GND q_ clk d
*.PININFO GND:B clk:I VP:B d:I q:O q_:O
x1 VP GND net1 net3 clk net4 NAND_3in
x2 VP GND net4 net2 net1 NAND_2in_x2
x3 VP GND net2 net1 clk NAND_2in_x2
x4 VP GND net1 q q_ NAND_2in_x2
x5 VP GND q q_ net3 NAND_2in_x2
x6 VP GND net3 net4 d NAND_2in_x2
.ends


* expanding   symbol:  /foss/designs/IHP__PLL0663/PLL0663-main/schematic/xschem/misc/level_shifter.sym # of pins=5
** sym_path: /foss/designs/IHP__PLL0663/PLL0663-main/schematic/xschem/misc/level_shifter.sym
** sch_path: /foss/designs/IHP__PLL0663/PLL0663-main/schematic/xschem/misc/level_shifter.sch
.subckt level_shifter vph out vpl in gd
*.PININFO in:I out:O gd:I vph:I vpl:I
MM1 1_stage_out in vpl vpl sg13_lv_pmos w=2u l=0.45u ng=1
MM3 1_stage_out in net1 gd sg13_lv_nmos w=1u l=0.45u ng=1
MM4 net1 in gd gd sg13_lv_nmos w=1u l=0.45u ng=1
MM2 2_stage_out 1_stage_out vpl vpl sg13_lv_pmos w=2u l=0.45u ng=1
MM5 2_stage_out 1_stage_out net4 gd sg13_lv_nmos w=1u l=0.45u ng=1
MM6 net4 1_stage_out gd gd sg13_lv_nmos w=1u l=0.45u ng=1
MM7 net2 3_stage_out vph vph sg13_hv_pmos w=1u l=0.45u ng=1
MM8 3_stage_out 2_stage_out gd gd sg13_hv_nmos w=4u l=0.45u ng=1
MM9 4 1_stage_out net2 vph sg13_hv_pmos w=1u l=0.45u ng=1
MM10 3_stage_out 2_stage_out net3 vph sg13_hv_pmos w=2u l=0.45u ng=1
MM11 net3 4 vph vph sg13_hv_pmos w=2u l=0.45u ng=1
MM12 4 1_stage_out gd gd sg13_hv_nmos w=2u l=0.45u ng=1
MM15 out 3_stage_out vph vph sg13_hv_pmos w=2u l=0.45u ng=1
MM14 out 3_stage_out net5 gd sg13_hv_nmos w=1u l=0.45u ng=1
MM13 net5 3_stage_out gd gd sg13_hv_nmos w=1u l=0.45u ng=1
.ends


* expanding   symbol:  /foss/designs/IHP__PLL0663/PLL0663-main/schematic/xschem/divider/inverter_x2.sym # of pins=4
** sym_path: /foss/designs/IHP__PLL0663/PLL0663-main/schematic/xschem/divider/inverter_x2.sym
** sch_path: /foss/designs/IHP__PLL0663/PLL0663-main/schematic/xschem/divider/inverter_x2.sch
.subckt inverter_x2 IN OUT VP GND
*.PININFO IN:I VP:B OUT:O GND:B
MM1 OUT IN GND GND sg13_lv_nmos w=0.30u l=0.13u ng=1
MM2 OUT IN VP VP sg13_lv_pmos w=0.30u l=0.13u ng=1
.ends


* expanding   symbol:  /foss/designs/IHP__PLL0663/PLL0663-main/schematic/xschem/divider/inverter_x4_top.sym # of pins=4
** sym_path: /foss/designs/IHP__PLL0663/PLL0663-main/schematic/xschem/divider/inverter_x4_top.sym
** sch_path: /foss/designs/IHP__PLL0663/PLL0663-main/schematic/xschem/divider/inverter_x4_top.sch
.subckt inverter_x4_top IN OUT VP GND
*.PININFO IN:I VP:B OUT:O GND:B
MM1 OUT IN GND GND sg13_lv_nmos w=0.60u l=0.13u ng=1
MM2 OUT IN VP VP sg13_lv_pmos w=0.60u l=0.13u ng=1
.ends


* expanding   symbol:  /foss/designs/IHP__PLL0663/PLL0663-main/schematic/xschem/charge_pump/charge_pump_cell.sym # of pins=6
** sym_path: /foss/designs/IHP__PLL0663/PLL0663-main/schematic/xschem/charge_pump/charge_pump_cell.sym
** sch_path: /foss/designs/IHP__PLL0663/PLL0663-main/schematic/xschem/charge_pump/charge_pump_cell.sch
.subckt charge_pump_cell vp UP vout DN rst gd
*.PININFO UP:B DN:B gd:B vp:B vout:O rst:B
x1 vp gd bias vbias
x2 vp net6 gd curr_source
MM20 net8 net15 vp vp sg13_lv_pmos w=1.6u l=0.6u ng=1
MM3 net15 bias net8 vp sg13_lv_pmos w=1.6u l=0.6u ng=1
MM12 net1 net6 vp vp sg13_lv_pmos w=1u l=0.6u ng=1
MM14 net1 bias net2 gd sg13_lv_nmos w=4.8u l=0.6u ng=1
MM9 net2 net1 gd gd sg13_lv_nmos w=4.8u l=0.6u ng=1
MM17 net7 net1 gd gd sg13_lv_nmos w=1.6u l=0.6u ng=1
MM6 net10 bias net7 gd sg13_lv_nmos w=1.6u l=0.6u ng=1
MM10 net5 net15 vp vp sg13_lv_pmos w=1.65u l=0.6u ng=1
MM2 net3 bias net5 vp sg13_lv_pmos w=1.6u l=0.6u ng=1
MM5 vout net9 net3 vp sg13_lv_pmos w=1u l=0.6u ng=1
MM7 net9 UP vp vp sg13_lv_pmos w=1u l=0.6u ng=1
MM4 net9 UP gd gd sg13_lv_nmos w=1u l=0.6u ng=1
MM11 vout DN net13 gd sg13_lv_nmos w=1u l=0.6u ng=1
MM13 net13 bias net4 gd sg13_lv_nmos w=1.6u l=0.6u ng=1
MM8 net4 net1 gd gd sg13_lv_nmos w=1.6u l=0.6u ng=1
MM15 vtest vtest vp vp sg13_lv_pmos w=1.8u l=1.8u ng=1
MM16 vtest vtest gd gd sg13_lv_nmos w=0.6u l=1.8u ng=1
MM18 vout rst vtest vp sg13_lv_pmos w=1.8u l=0.6u ng=1
MM1 net15 bias net10 gd sg13_lv_nmos w=1.6u l=0.6u ng=1
MM19 gd gd gd gd sg13_lv_nmos w=1.6u l=0.6u ng=1
MM21 gd gd gd gd sg13_lv_nmos w=0.6u l=1.8u ng=1
MM22 gd gd gd gd sg13_lv_nmos w=0.46u l=1.8u ng=1 m=2
MM23 gd gd gd gd sg13_lv_nmos w=1u l=0.6u ng=1
MM24 vp vp vp vp sg13_lv_pmos w=1.8u l=0.6u ng=1
MM25 gd gd gd gd sg13_lv_nmos w=1.86u l=0.6u ng=1
MM26 gd gd gd gd sg13_lv_nmos w=1.2u l=0.6u ng=1
MM27 vp vp vp vp sg13_lv_pmos w=1.375u l=0.6u ng=1
RR1 gd gd 199.2 $SUB=gd $[rppd] w=1u l=0.5u b=0
.ends


* expanding   symbol:  /foss/designs/IHP__PLL0663/PLL0663-main/schematic/xschem/divider/inverter_x4.sym # of pins=4
** sym_path: /foss/designs/IHP__PLL0663/PLL0663-main/schematic/xschem/divider/inverter_x4.sym
** sch_path: /foss/designs/IHP__PLL0663/PLL0663-main/schematic/xschem/divider/inverter_x4.sch
.subckt inverter_x4 IN OUT VP GND
*.PININFO IN:I VP:B OUT:O GND:B
MM1 OUT IN GND GND sg13_lv_nmos w=0.60u l=0.13u ng=1
MM2 OUT IN VP VP sg13_lv_pmos w=0.60u l=0.13u ng=1
.ends


* expanding   symbol:  /foss/designs/IHP__PLL0663/PLL0663-main/schematic/xschem/vco/vco_top.sym # of pins=13
** sym_path: /foss/designs/IHP__PLL0663/PLL0663-main/schematic/xschem/vco/vco_top.sym
** sch_path: /foss/designs/IHP__PLL0663/PLL0663-main/schematic/xschem/vco/vco_top.sch
.subckt vco_top out gd VP c0 c1 c2 f0 f1 f2 f3 f4 f5 vco_in
*.PININFO gd:B VP:B c1:I c2:I f0:I f1:I c0:I f2:I f3:I f4:I f5:I out:O vco_in:I
x1 VP_vco0 gd net1 net10 vco_core_0
x2 VP_vco1 gd net2 VCO2_5_sel net6 nVCO2_11_sel nVCO2_5_sel VCO2_11_sel vco_core_1
x3 VP_vco2 gd net3 net7 VCO3_5_sel nVCO3_5_sel nVCO3_11_sel VCO3_11_sel vco_core_2
x4 VP_vco3 gd net4 net8 VCO4_5_sel nVCO4_5_sel nVCO4_11_sel VCO4_11_sel vco_core_3
x5 VP_vco4 gd net5 net9 vco_core_4
x6 VP gd vco_0_out net1 0_buf
x7 VP gd vco_1_out net2 0_buf
x8 VP gd vco_2_out net3 0_buf
x9 VP gd vco_3_out net4 0_buf
x10 VP gd vco_4_out net5 0_buf
x11 gd VP c0 c1 c2 f0 f1 f2 f3 f4 f5 vco_0_out vco_1_out vco_2_out vco_3_out vco_4_out VCO2_11_sel VCO2_5_sel VCO3_11_sel
+ VCO3_5_sel VCO4_11_sel VCO4_5_sel out VCO4_SEL VCO3_SEL VCO2_SEL VCO_SEL VCO5_SEL VCO_MUX_and_decoder
x12 VCO2_5_sel nVCO2_5_sel VP gd inverter
x13 VCO2_11_sel nVCO2_11_sel VP gd inverter
x14 VCO3_5_sel nVCO3_5_sel VP gd inverter
x15 VCO3_11_sel nVCO3_11_sel VP gd inverter
x16 VCO4_5_sel nVCO4_5_sel VP gd inverter
x17 VCO4_11_sel nVCO4_11_sel VP gd inverter
x19 VCO_SEL VCO_SEL_n VP gd inverter
x21 VCO2_SEL VCO2_SEL_n VP gd inverter
x23 VCO3_SEL VCO3_SEL_n VP gd inverter
x25 VCO4_SEL VCO4_SEL_n VP gd inverter
x27 VCO5_SEL VCO5_SEL_n VP gd inverter
MM1 net6 VCO2_SEL_n gd gd sg13_lv_nmos w=0.3u l=0.13u ng=1
MM6 VP_vco4 VCO5_SEL_n gd gd sg13_lv_nmos w=0.3u l=0.13u ng=1
MM7 VP_vco3 VCO4_SEL_n gd gd sg13_lv_nmos w=0.3u l=0.13u ng=1
MM8 VP_vco2 VCO3_SEL_n gd gd sg13_lv_nmos w=0.3u l=0.13u ng=1
MM9 VP_vco1 VCO2_SEL_n gd gd sg13_lv_nmos w=0.3u l=0.13u ng=1
MM10 VP_vco0 VCO_SEL_n gd gd sg13_lv_nmos w=0.3u l=0.13u ng=1
x28 VCO2_SEL VP vco_in net6 gd VCO2_SEL_n PFD_passgate
MM2 net7 VCO3_SEL_n gd gd sg13_lv_nmos w=0.3u l=0.13u ng=1
x26 VCO3_SEL VP vco_in net7 gd VCO3_SEL_n PFD_passgate
MM3 net8 VCO4_SEL_n gd gd sg13_lv_nmos w=0.3u l=0.13u ng=1
x29 VCO4_SEL VP vco_in net8 gd VCO4_SEL_n PFD_passgate
MM4 net9 VCO5_SEL_n gd gd sg13_lv_nmos w=0.3u l=0.13u ng=1
x30 VCO5_SEL VP vco_in net9 gd VCO5_SEL_n PFD_passgate
MM5 net10 VCO_SEL_n gd gd sg13_lv_nmos w=0.3u l=0.13u ng=1
x31 VCO_SEL VP vco_in net10 gd VCO_SEL_n PFD_passgate
x18 VCO_SEL_n VP gd VCO_SEL VP VP_vco0 vco_passgate
x20 VCO2_SEL_n VP gd VCO2_SEL VP VP_vco1 vco_passgate
x22 VCO3_SEL_n VP gd VCO3_SEL VP VP_vco2 vco_passgate
x24 VCO4_SEL_n VP gd VCO4_SEL VP VP_vco3 vco_passgate
x32 VCO5_SEL_n VP gd VCO5_SEL VP VP_vco4 vco_passgate
.ends


* expanding   symbol:  /foss/designs/IHP__PLL0663/PLL0663-main/schematic/xschem/divider/NAND_2in_x2.sym # of pins=5
** sym_path: /foss/designs/IHP__PLL0663/PLL0663-main/schematic/xschem/divider/NAND_2in_x2.sym
** sch_path: /foss/designs/IHP__PLL0663/PLL0663-main/schematic/xschem/divider/NAND_2in_x2.sch
.subckt NAND_2in_x2 VP GND a y b
*.PININFO y:O GND:B a:I VP:B b:I
MM1 y a net1 GND sg13_lv_nmos w=0.6u l=0.13u ng=1
MM2 y b VP VP sg13_lv_pmos w=0.3u l=0.13u ng=1
MM3 net1 b GND GND sg13_lv_nmos w=0.6u l=0.13u ng=1
MM4 y a VP VP sg13_lv_pmos w=0.3u l=0.13u ng=1
.ends


* expanding   symbol:  /foss/designs/IHP__PLL0663/PLL0663-main/schematic/xschem/buf/buf_lp.sym # of pins=4
** sym_path: /foss/designs/IHP__PLL0663/PLL0663-main/schematic/xschem/buf/buf_lp.sym
** sch_path: /foss/designs/IHP__PLL0663/PLL0663-main/schematic/xschem/buf/buf_lp.sch
.subckt buf_lp VDD INPUT OUT GND
*.PININFO INPUT:I VDD:B GND:B OUT:O
MM9 OUT net3 VDD VDD sg13_hv_pmos w=3u l=0.4u ng=1 m=4
MM6 net3 net2 VDD VDD sg13_hv_pmos w=3u l=0.4u ng=1 m=3
MM4 net2 net1 VDD VDD sg13_hv_pmos w=3u l=0.4u ng=1 m=2
MM2 net1 INPUT VDD VDD sg13_hv_pmos w=3u l=0.4u ng=1
MM1 OUT net3 GND GND sg13_hv_nmos w=2u l=0.45u ng=1 m=4
MM3 net3 net2 GND GND sg13_hv_nmos w=2u l=0.45u ng=1 m=3
MM5 net2 net1 GND GND sg13_hv_nmos w=2u l=0.45u ng=1 m=2
MM7 net1 INPUT GND GND sg13_hv_nmos w=2u l=0.45u ng=1
.ends


* expanding   symbol:  /foss/designs/IHP__PLL0663/PLL0663-main/schematic/xschem/misc/mux8to1.sym # of pins=14
** sym_path: /foss/designs/IHP__PLL0663/PLL0663-main/schematic/xschem/misc/mux8to1.sym
** sch_path: /foss/designs/IHP__PLL0663/PLL0663-main/schematic/xschem/misc/mux8to1.sch
.subckt mux8to1 gd vp A0 out in1 in2 in3 in4 in5 in6 in7 A1 in8 A2
*.PININFO gd:B vp:B out:O in1:I in2:I in3:I in4:I in5:I in6:I in7:I in8:I A0:I A1:I A2:I
x9 A0 net1 vp gd inverter_x4
x10 A1 net2 vp gd inverter_x4
x11 A2 net3 vp gd inverter_x4
x28 out_unb out vp gd inverter_x4
x29 in4 net8 vp gd inverter_x4
x30 in8 net4 vp gd inverter_x4
x31 in7 net5 vp gd inverter_x4
x32 in6 net6 vp gd inverter_x4
x33 in5 net7 vp gd inverter_x4
x34 in1 net11 vp gd inverter_x4
x35 in2 net10 vp gd inverter_x4
x36 in3 net9 vp gd inverter_x4
x13 en1_ en1 vp gd inverter_x4
x15 en2_ en2 vp gd inverter_x4
x17 en3_ en3 vp gd inverter_x4
x19 en4_ en4 vp gd inverter_x4
x21 en5_ en5 vp gd inverter_x4
x23 en6_ en6 vp gd inverter_x4
x25 en7_ en7 vp gd inverter_x4
x27 en8_ en8 vp gd inverter_x4
x12 vp gd net3 en1_ net2 net1 NAND_3in
x14 vp gd net2 en2_ net3 A0 NAND_3in
x16 vp gd net1 en3_ net3 A1 NAND_3in
x18 vp gd net3 en4_ A1 A0 NAND_3in
x20 vp gd net1 en5_ net2 A2 NAND_3in
x22 vp gd net2 en6_ A2 A0 NAND_3in
x24 vp gd net1 en7_ A2 A1 NAND_3in
x26 vp gd A2 en8_ A1 A0 NAND_3in
x1 en8_ vp gd en8 net4 out_unb passgate
x2 en4_ vp gd en4 net8 out_unb passgate
x3 en7_ vp gd en7 net5 out_unb passgate
x4 en3_ vp gd en3 net9 out_unb passgate
x5 en6_ vp gd en6 net6 out_unb passgate
x6 en2_ vp gd en2 net10 out_unb passgate
x7 en5_ vp gd en5 net7 out_unb passgate
x8 en1_ vp gd en1 net11 out_unb passgate
.ends


* expanding   symbol:  /foss/designs/IHP__PLL0663/PLL0663-main/schematic/xschem/misc/debug_level_shifter.sym # of pins=5
** sym_path: /foss/designs/IHP__PLL0663/PLL0663-main/schematic/xschem/misc/debug_level_shifter.sym
** sch_path: /foss/designs/IHP__PLL0663/PLL0663-main/schematic/xschem/misc/debug_level_shifter.sch
.subckt debug_level_shifter vph out vpl in gd
*.PININFO in:I out:O gd:I vph:I vpl:I
MM1 1_stage_out in vpl vpl sg13_lv_pmos w=2u l=0.45u ng=1
MM3 1_stage_out in net1 gd sg13_lv_nmos w=1u l=0.45u ng=1
MM4 net1 in gd gd sg13_lv_nmos w=1u l=0.45u ng=1
MM2 2_stage_out 1_stage_out vpl vpl sg13_lv_pmos w=2u l=0.45u ng=1
MM5 2_stage_out 1_stage_out net4 gd sg13_lv_nmos w=1u l=0.45u ng=1
MM6 net4 1_stage_out gd gd sg13_lv_nmos w=1u l=0.45u ng=1
MM7 net2 3_stage_out vph vph sg13_hv_pmos w=1u l=0.45u ng=1
MM8 3_stage_out 2_stage_out gd gd sg13_hv_nmos w=4u l=0.45u ng=1
MM9 4 1_stage_out net2 vph sg13_hv_pmos w=1u l=0.45u ng=1
MM10 3_stage_out 2_stage_out net3 vph sg13_hv_pmos w=2u l=0.45u ng=1
MM11 net3 4 vph vph sg13_hv_pmos w=2u l=0.45u ng=1
MM12 4 1_stage_out gd gd sg13_hv_nmos w=2u l=0.45u ng=1
MM15 out 3_stage_out vph vph sg13_hv_pmos w=2u l=0.45u ng=1
MM14 out 3_stage_out net5 gd sg13_hv_nmos w=1u l=0.45u ng=1
MM13 net5 3_stage_out gd gd sg13_hv_nmos w=1u l=0.45u ng=1
.ends


* expanding   symbol:  /foss/designs/IHP__PLL0663/PLL0663-main/schematic/xschem/PFD/PFD_passgate.sym # of pins=6
** sym_path: /foss/designs/IHP__PLL0663/PLL0663-main/schematic/xschem/PFD/PFD_passgate.sym
** sch_path: /foss/designs/IHP__PLL0663/PLL0663-main/schematic/xschem/PFD/PFD_passgate.sch
.subckt PFD_passgate in_n vp A B gnd in_p
*.PININFO in_n:I in_p:I vp:B gnd:B B:B A:B
MM4 B in_p A vp sg13_lv_pmos w=0.3u l=0.15u ng=1
MM5 B in_n A gnd sg13_lv_nmos w=0.3u l=0.15u ng=1
.ends


* expanding   symbol:  /foss/designs/IHP__PLL0663/PLL0663-main/schematic/xschem/divider/NAND_2in.sym # of pins=5
** sym_path: /foss/designs/IHP__PLL0663/PLL0663-main/schematic/xschem/divider/NAND_2in.sym
** sch_path: /foss/designs/IHP__PLL0663/PLL0663-main/schematic/xschem/divider/NAND_2in.sch
.subckt NAND_2in VP GND a y b
*.PININFO y:O GND:B a:I VP:B b:I
MM1 y a net1 GND sg13_lv_nmos w=0.15u l=0.13u ng=1
MM3 net1 b GND GND sg13_lv_nmos w=0.15u l=0.13u ng=1
MM2 y b VP VP sg13_lv_pmos w=0.15u l=0.13u ng=1
MM4 y a VP VP sg13_lv_pmos w=0.15u l=0.13u ng=1
.ends


* expanding   symbol:  /foss/designs/IHP__PLL0663/PLL0663-main/schematic/xschem/PFD/PFD_buffor.sym # of pins=4
** sym_path: /foss/designs/IHP__PLL0663/PLL0663-main/schematic/xschem/PFD/PFD_buffor.sym
** sch_path: /foss/designs/IHP__PLL0663/PLL0663-main/schematic/xschem/PFD/PFD_buffor.sch
.subckt PFD_buffor gnd vp out in
*.PININFO gnd:B vp:B in:I out:B
MM1 out_stage1 in gnd gnd sg13_lv_nmos w=0.4u l=0.75u ng=1
MM4 out_stage1 in vp vp sg13_lv_pmos w=0.4u l=0.75u ng=1
MM2 out out_stage1 gnd gnd sg13_lv_nmos w=0.4u l=0.75u ng=1
MM3 out out_stage1 vp vp sg13_lv_pmos w=0.4u l=0.75u ng=1
.ends


* expanding   symbol:  /foss/designs/IHP__PLL0663/PLL0663-main/schematic/xschem/PFD/PFD_flip_flop.sym # of pins=7
** sym_path: /foss/designs/IHP__PLL0663/PLL0663-main/schematic/xschem/PFD/PFD_flip_flop.sym
** sch_path: /foss/designs/IHP__PLL0663/PLL0663-main/schematic/xschem/PFD/PFD_flip_flop.sch
.subckt PFD_flip_flop clk rst D Q NQ vp gd
*.PININFO D:I Q:O NQ:O clk:I rst:I gd:I vp:I
x8 clk vp post_NOR 1 gd clk_n PFD_passgate
x4 clk vp 2 3 gd clk_n PFD_passgate
x7 clk_n vp NQ 3 gd clk PFD_passgate
x3 vp rst 3 Q gd PFD_NOR
x5 vp rst 2 post_NOR gd PFD_NOR
x1 clk_n vp D 1 gd clk PFD_passgate
MM1 gd 1 gd gd sg13_lv_nmos w=10u l=5u ng=1
MM2 gd 3 gd gd sg13_lv_nmos w=10u l=5u ng=1
MM3 gd 2 gd gd sg13_lv_nmos w=10u l=5u ng=1
x9 1 2 vp gd PFD_inverter_x8
x6 Q NQ vp gd PFD_inverter_x8
x2 clk clk_n vp gd PFD_inverter_x4
.ends


* expanding   symbol:  /foss/designs/IHP__PLL0663/PLL0663-main/schematic/xschem/PFD/PFD_inverter_x4.sym # of pins=4
** sym_path: /foss/designs/IHP__PLL0663/PLL0663-main/schematic/xschem/PFD/PFD_inverter_x4.sym
** sch_path: /foss/designs/IHP__PLL0663/PLL0663-main/schematic/xschem/PFD/PFD_inverter_x4.sch
.subckt PFD_inverter_x4 IN OUT VP GND
*.PININFO IN:I VP:B OUT:O GND:B
MM1 OUT IN GND GND sg13_lv_nmos w=0.60u l=0.13u ng=1
MM2 OUT IN VP VP sg13_lv_pmos w=0.60u l=0.13u ng=1
.ends


* expanding   symbol:  /foss/designs/IHP__PLL0663/PLL0663-main/schematic/xschem/divider/2Div.sym # of pins=10
** sym_path: /foss/designs/IHP__PLL0663/PLL0663-main/schematic/xschem/divider/2Div.sym
** sch_path: /foss/designs/IHP__PLL0663/PLL0663-main/schematic/xschem/divider/2Div.sch
.subckt 2Div gd vp in div2 div4 div8 div16 div32 div64 div128
*.PININFO gd:B in:I vp:B div2:O div4:O div8:O div16:O div32:O div64:O div128:O
x3 div32 vp gd net5 div16 net5 d_flip_flop
x4 div64 vp gd net6 div32 net6 d_flip_flop
x7 div128 vp gd net7 div64 net7 d_flip_flop
x1 div2 vp gd net1 in net1 d_flip_flop
x2 div4 vp gd net2 div2 net2 d_flip_flop
x5 div8 vp gd net3 div4 net3 d_flip_flop
x6 div16 vp gd net4 div8 net4 d_flip_flop
.ends


* expanding   symbol:  /foss/designs/IHP__PLL0663/PLL0663-main/schematic/xschem/divider/MUX_8to1.sym # of pins=14
** sym_path: /foss/designs/IHP__PLL0663/PLL0663-main/schematic/xschem/divider/MUX_8to1.sym
** sch_path: /foss/designs/IHP__PLL0663/PLL0663-main/schematic/xschem/divider/MUX_8to1.sch
.subckt MUX_8to1 gd vp A0 out in1 in2 in3 in4 in5 in6 in7 A1 in8 A2
*.PININFO gd:B vp:B out:O in1:I in2:I in3:I in4:I in5:I in6:I in7:I in8:I A0:I A1:I A2:I
x9 A0 net1 vp gd inverter_x4
x10 A1 net2 vp gd inverter_x4
x11 A2 net3 vp gd inverter_x4
x28 out_unb out vp gd inverter_x4
x29 in4 net8 vp gd inverter_x4
x30 in8 net4 vp gd inverter_x4
x31 in7 net5 vp gd inverter_x4
x32 in6 net6 vp gd inverter_x4
x33 in5 net7 vp gd inverter_x4
x34 in1 net11 vp gd inverter_x4
x35 in2 net10 vp gd inverter_x4
x36 in3 net9 vp gd inverter_x4
x13 en1_ en1 vp gd inverter_x4
x15 en2_ en2 vp gd inverter_x4
x17 en3_ en3 vp gd inverter_x4
x19 en4_ en4 vp gd inverter_x4
x21 en5_ en5 vp gd inverter_x4
x23 en6_ en6 vp gd inverter_x4
x25 en7_ en7 vp gd inverter_x4
x27 en8_ en8 vp gd inverter_x4
x12 vp gd net3 en1_ net2 net1 NAND_3in
x14 vp gd net2 en2_ net3 A0 NAND_3in
x16 vp gd net1 en3_ net3 A1 NAND_3in
x18 vp gd net3 en4_ A1 A0 NAND_3in
x20 vp gd net1 en5_ net2 A2 NAND_3in
x22 vp gd net2 en6_ A2 A0 NAND_3in
x24 vp gd net1 en7_ A2 A1 NAND_3in
x26 vp gd A2 en8_ A1 A0 NAND_3in
x1 en8_ vp gd en8 net4 out_unb passgate
x2 en4_ vp gd en4 net8 out_unb passgate
x3 en7_ vp gd en7 net5 out_unb passgate
x4 en3_ vp gd en3 net9 out_unb passgate
x5 en6_ vp gd en6 net6 out_unb passgate
x6 en2_ vp gd en2 net10 out_unb passgate
x7 en5_ vp gd en5 net7 out_unb passgate
x8 en1_ vp gd en1 net11 out_unb passgate
.ends


* expanding   symbol:  /foss/designs/IHP__PLL0663/PLL0663-main/schematic/xschem/divider/pdiv.sym # of pins=11
** sym_path: /foss/designs/IHP__PLL0663/PLL0663-main/schematic/xschem/divider/pdiv.sym
** sch_path: /foss/designs/IHP__PLL0663/PLL0663-main/schematic/xschem/divider/pdiv.sch
.subckt pdiv gd VP clk reset d0 d1 d2 d3 d4 d5 out_div
*.PININFO gd:B clk:I VP:B d0:I d1:I d2:I d3:I d4:I d5:I out_div:O reset:I
x4 VP gd d0 d012 d1 d2 NAND_3in
x7 VP gd d3 d345 d4 d5 NAND_3in
x5 VP gd d012 bypass d345 NOR_2in
x1 gd VP clk out r_div2 r_div4 r_div8 r_div16 r_div32 r_div64 div_with_reset
x2 out_pre_buff VP gd r_div2 r_div4 r_div8 r_div16 r_div32 r_div64 d0 d1 d2 d3 d4 d5 count_data_check
x11 out_div VP gd net2 net1 net2 net4 d_flip_flop_reset
x13 out_pre_buff out VP gd inverter_x8
x3 net3 VP gd bypass clk net1 passgate
x8 bypass VP gd net3 out net1 passgate
x6 bypass net3 VP gd inverter_x4
x9 reset net4 VP gd inverter_x4
.ends


* expanding   symbol:  /foss/designs/IHP__PLL0663/PLL0663-main/schematic/xschem/divider/NAND_3in.sym # of pins=6
** sym_path: /foss/designs/IHP__PLL0663/PLL0663-main/schematic/xschem/divider/NAND_3in.sym
** sch_path: /foss/designs/IHP__PLL0663/PLL0663-main/schematic/xschem/divider/NAND_3in.sch
.subckt NAND_3in VP GND a y b c
*.PININFO y:O GND:B a:I VP:B b:I c:I
MM1 y a net2 GND sg13_lv_nmos w=0.3u l=0.13u ng=1
MM3 net2 b net1 GND sg13_lv_nmos w=0.3u l=0.13u ng=1
MM4 net1 c GND GND sg13_lv_nmos w=0.3u l=0.13u ng=1
MM7 y c VP VP sg13_lv_pmos w=0.15u l=0.13u ng=1
MM2 y a VP VP sg13_lv_pmos w=0.15u l=0.13u ng=1
MM5 y b VP VP sg13_lv_pmos w=0.15u l=0.13u ng=1
.ends


* expanding   symbol:  /foss/designs/IHP__PLL0663/PLL0663-main/schematic/xschem/charge_pump/vbias.sym # of pins=3
** sym_path: /foss/designs/IHP__PLL0663/PLL0663-main/schematic/xschem/charge_pump/vbias.sym
** sch_path: /foss/designs/IHP__PLL0663/PLL0663-main/schematic/xschem/charge_pump/vbias.sch
.subckt vbias vp gd vbias
*.PININFO vbias:O gd:B vp:B
MM5 net1 iref vp vp sg13_lv_pmos w=1.2u l=0.6u ng=1
MM6 vbias net1 net2 gd sg13_lv_nmos w=3.6u l=0.6u ng=1
MM2 net2 net2 gd gd sg13_lv_nmos w=1.2u l=0.6u ng=1
MM3 gd gd gd gd sg13_lv_nmos w=1.86u l=0.6u ng=1
MM7 vp vp vp vp sg13_lv_pmos w=1.375u l=0.6u ng=1
RR1 net1 vbias 509.4 $SUB=gd $[rppd] w=1e-6 l=1.7e-6 b=0
x1 vp iref gd curr_source
.ends


* expanding   symbol:  /foss/designs/IHP__PLL0663/PLL0663-main/schematic/xschem/charge_pump/curr_source.sym # of pins=3
** sym_path: /foss/designs/IHP__PLL0663/PLL0663-main/schematic/xschem/charge_pump/curr_source.sym
** sch_path: /foss/designs/IHP__PLL0663/PLL0663-main/schematic/xschem/charge_pump/curr_source.sch
.subckt curr_source vp iref gd
*.PININFO vp:B gd:B iref:O
MM9 net3 net3 gd gd sg13_lv_nmos w=1u l=0.6u ng=1
MM4 iref iref vp vp sg13_lv_pmos w=1.4u l=0.6u ng=1
MM5 net2 iref vp vp sg13_lv_pmos w=1.2u l=0.6u ng=1
MM10 iref net2 net1 gd sg13_lv_nmos w=1.2u l=0.6u ng=1
MM1 net2 net2 gd gd sg13_lv_nmos w=1.4u l=0.6u ng=1
MM3 vp vp net3 gd sg13_lv_nmos w=1u l=0.6u ng=1
MM6 vp net3 iref gd sg13_lv_nmos w=1u l=0.6u ng=1
MM2 gd gd gd gd sg13_lv_nmos w=0.4u l=0.6u ng=1
RR2 net1 gd 509.4 $SUB=gd $[rppd] w=1e-6 l=1.7e-6 b=0
.ends


* expanding   symbol:  /foss/designs/IHP__PLL0663/PLL0663-main/schematic/xschem/vco/vco_core_0.sym # of pins=4
** sym_path: /foss/designs/IHP__PLL0663/PLL0663-main/schematic/xschem/vco/vco_core_0.sym
** sch_path: /foss/designs/IHP__PLL0663/PLL0663-main/schematic/xschem/vco/vco_core_0.sch
.subckt vco_core_0 vp gnd out in
*.PININFO in:I vp:B out:O gnd:B
MM1 pgt in gnd gnd sg13_lv_nmos w=0.8u l=0.14*4u ng=1
MM2 pgt pgt vp vp sg13_lv_pmos w=1.2u l=0.14*4u ng=1
x1 vp pgt out net1 in gnd vco_delay_cell_0
x2 vp pgt net1 2th in gnd vco_delay_cell_0
x3 vp pgt 2th 3th in gnd vco_delay_cell_0
x4 vp pgt 3th 4th in gnd vco_delay_cell_0
x7 vp pgt 4th out in gnd vco_delay_cell_0
.ends
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
