DamianSeredyn/IHP__PLL0663/(commit log)

2026-10-31 first iteration of fixes
    [0_buf.sch, 2Div.sch, 2Div_tb.sch, 3bit_to_8_outs.sch, Divider_top.sch, MUX_8to1.sch, MUX_8to1_debug.sch, MUX_8to1_tb.sch]
2026-10-31 add proper PLL0633 cell
    [PLL0663.sch, chip_top.sch]
2026-11-01 add pins to chip schematic, fix vph in chip_top
    [PLL0663.sch, chip_top.sch]
2026-11-01 first iteration of datasheet
    [PLL0663.sch, chip_top.sch]
2026-11-01 Third iteration of Datasheet
    [curr_source.sch, vbias.sch]
2026-11-02 updated bonding script output files and config.yaml - needs verification and update on qty, die thickness, die attach, lid and request
